TheGoldenPorkchop/RCETLaserArcade/VBArcadeControl/VBArcadeControl/Resources/UIPlayer4.png

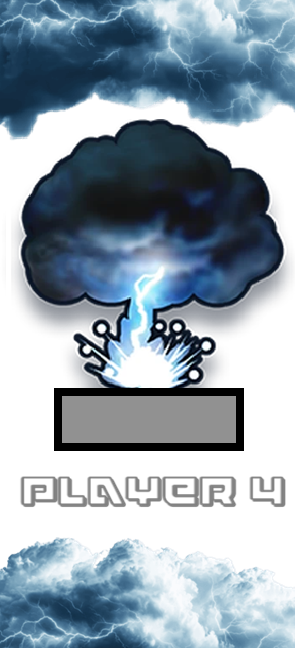
VBArcadeControl/VBArcadeControl/Resources/UIPlayer4.png
