TheGoldenPorkchop/RCETLaserArcade/KiCad/Target_Jumper/Target_Jumper_RevA/Target_Jumper.png

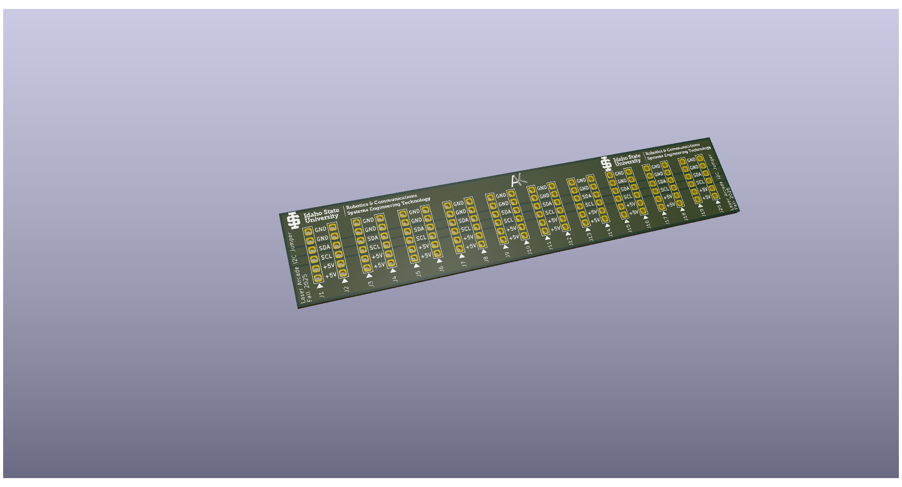
KiCad/Target_Jumper/Target_Jumper_RevA/Target_Jumper.png
