TheGoldenPorkchop/RCETLaserArcade/KiCad/Target_Jumper/Target_Jumper_RevA/LA_TargetJumper_RevA_BottomSchematic.pdf

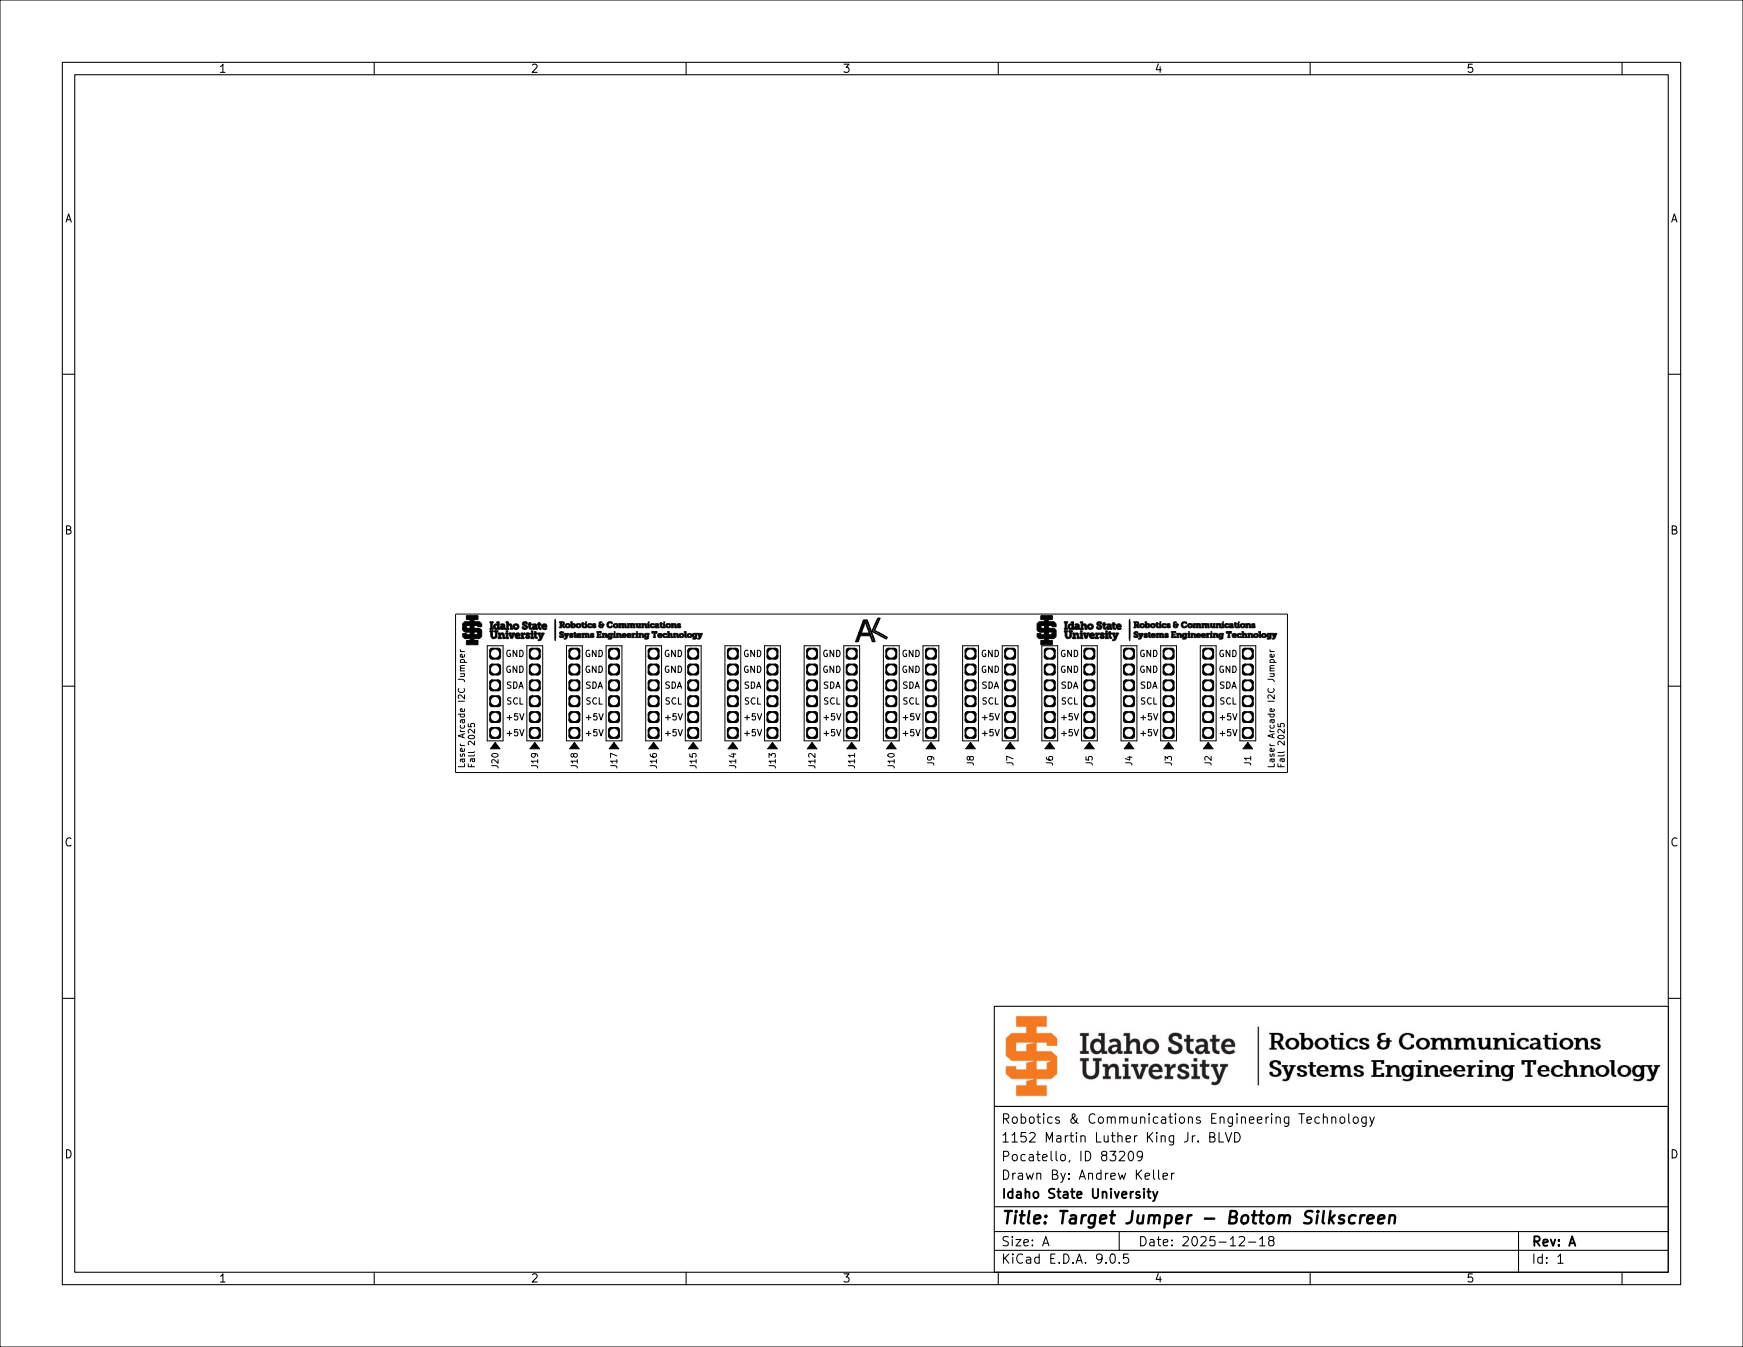
[picture p7: page 1]
