TheGoldenPorkchop/RCETLaserArcade/KiCad/Target_Jumper/Target_Jumper_RevA/LA_TargetJumper_RevA_Mechanical.pdf

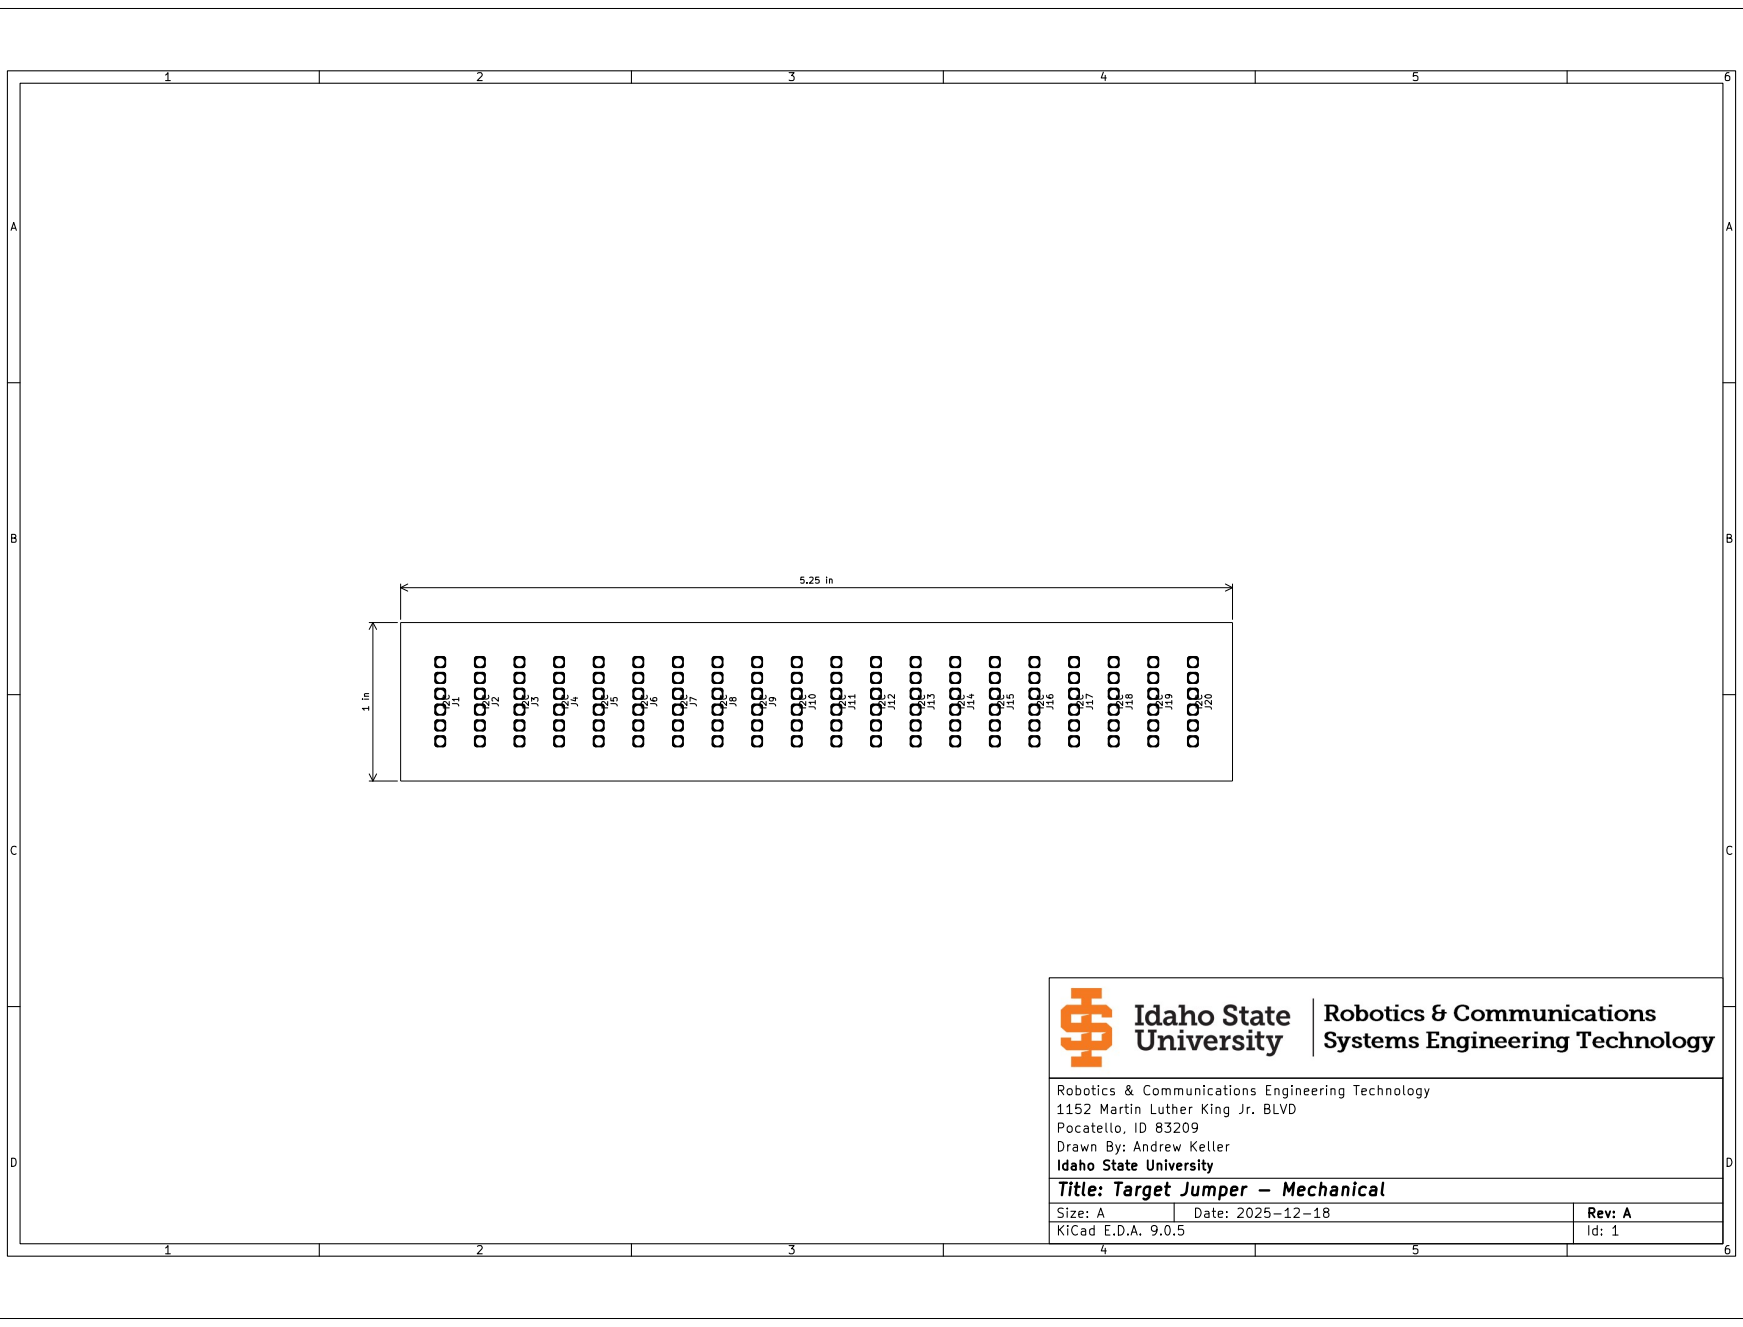
[picture p8: page 1]
