TheGoldenPorkchop/RCETLaserArcade/KiCad/Target_Jumper/Target_Jumper_RevA/LA_TargetJumper_RevA_Schematic.pdf

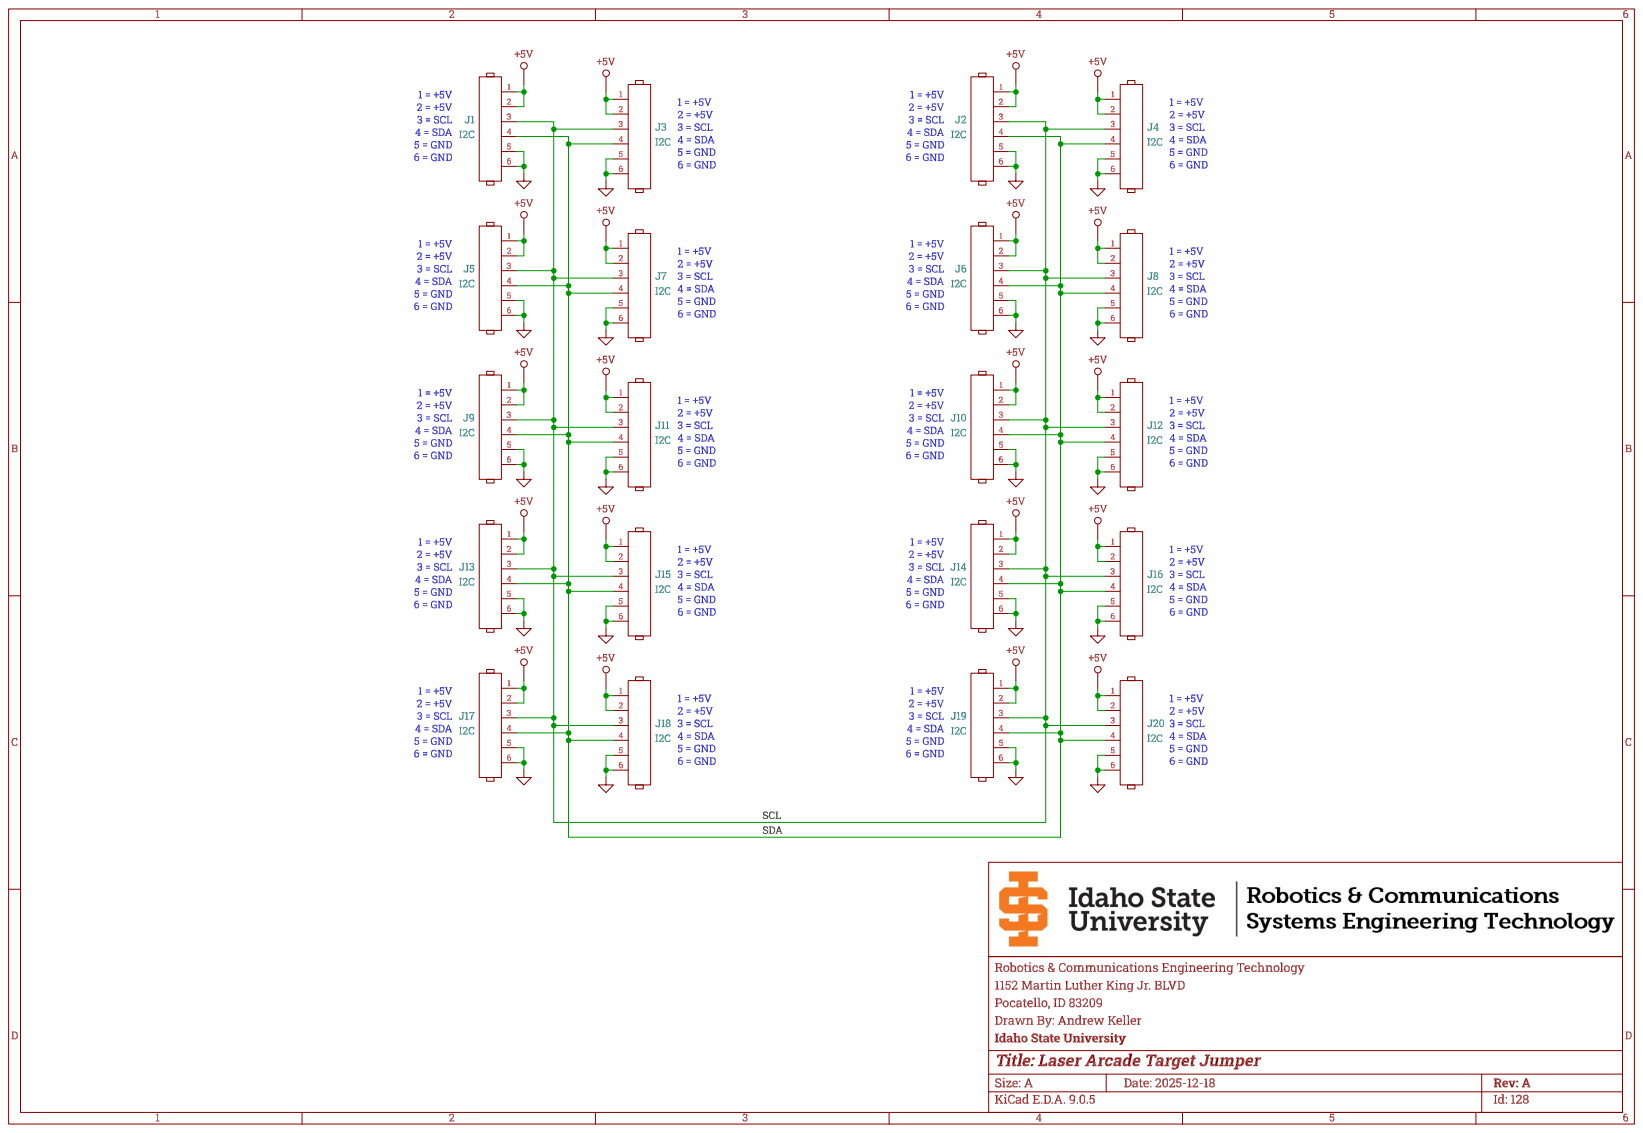
[picture p9: page 1]
