TheGoldenPorkchop/RCETLaserArcade/KiCad/Target_Master/Target_Master_RevB/LA_TargetMaster_RevB_Schematic.pdf

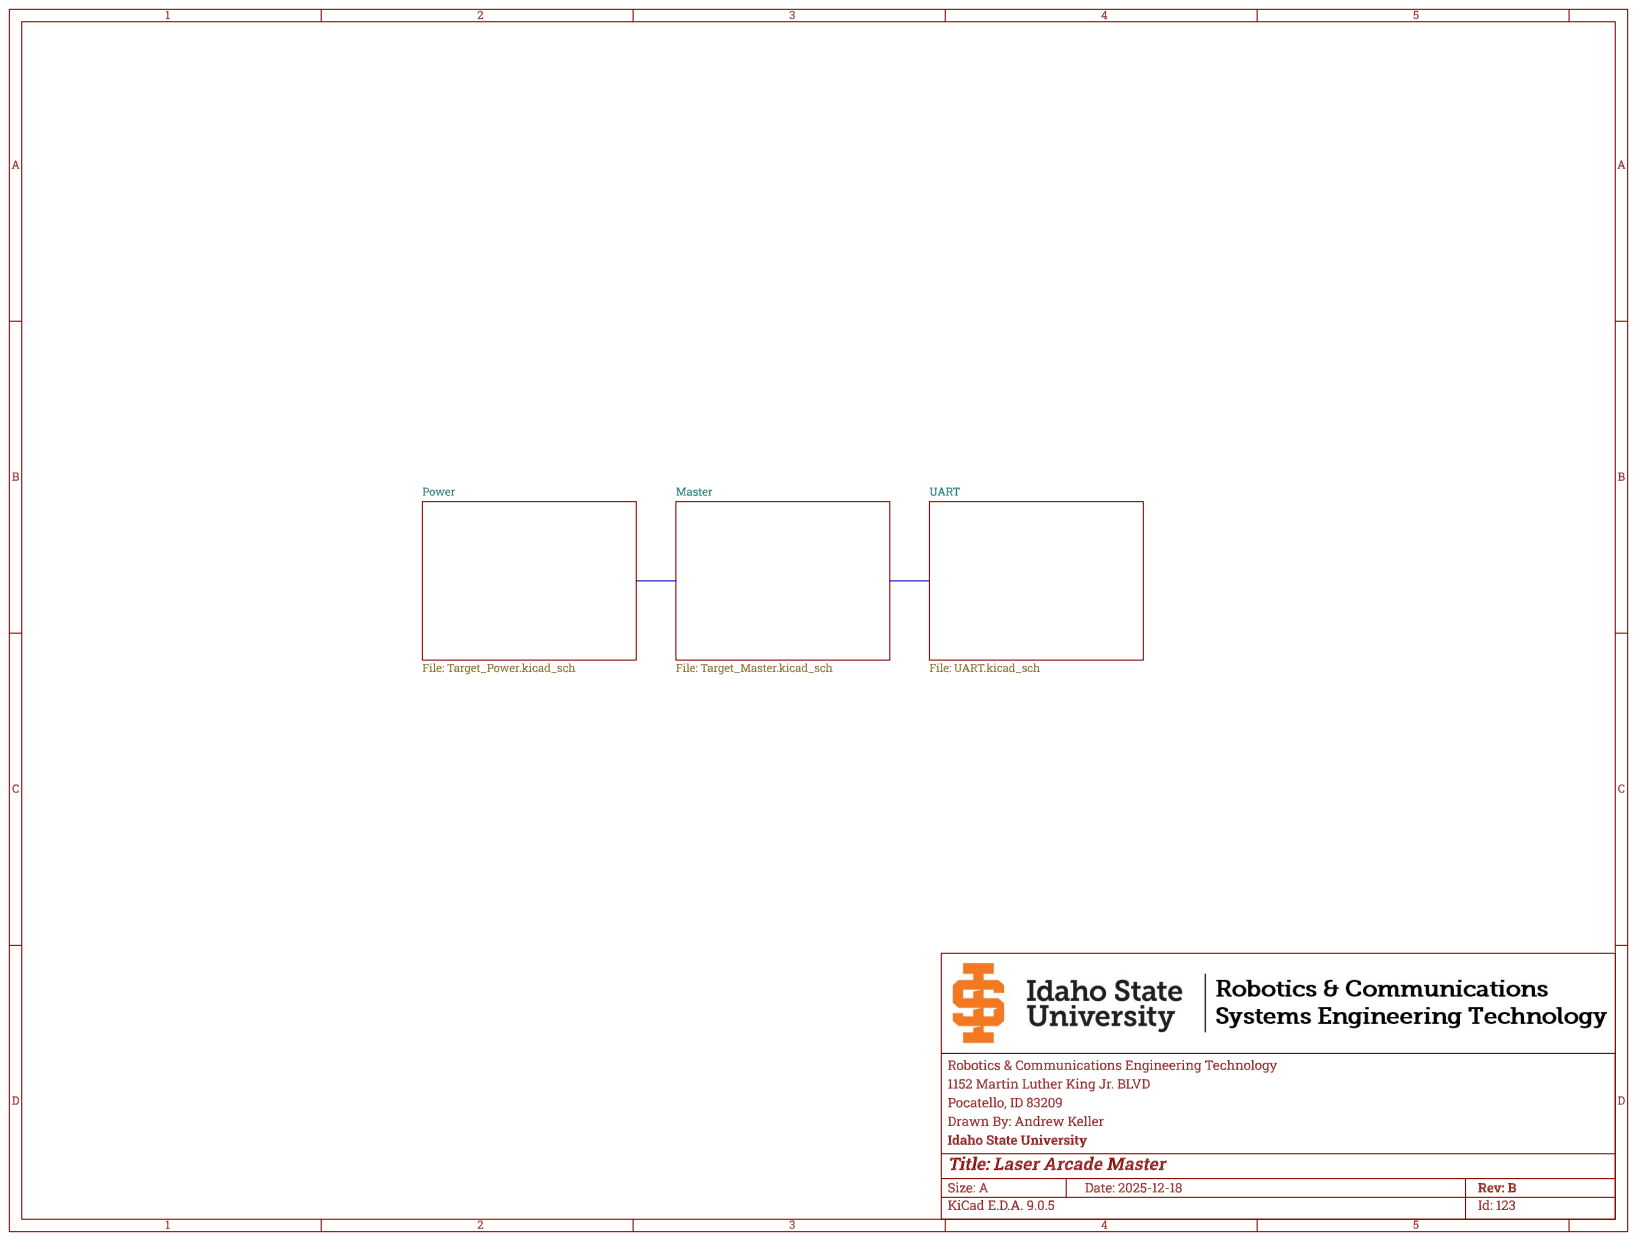
[picture p10: page 1]

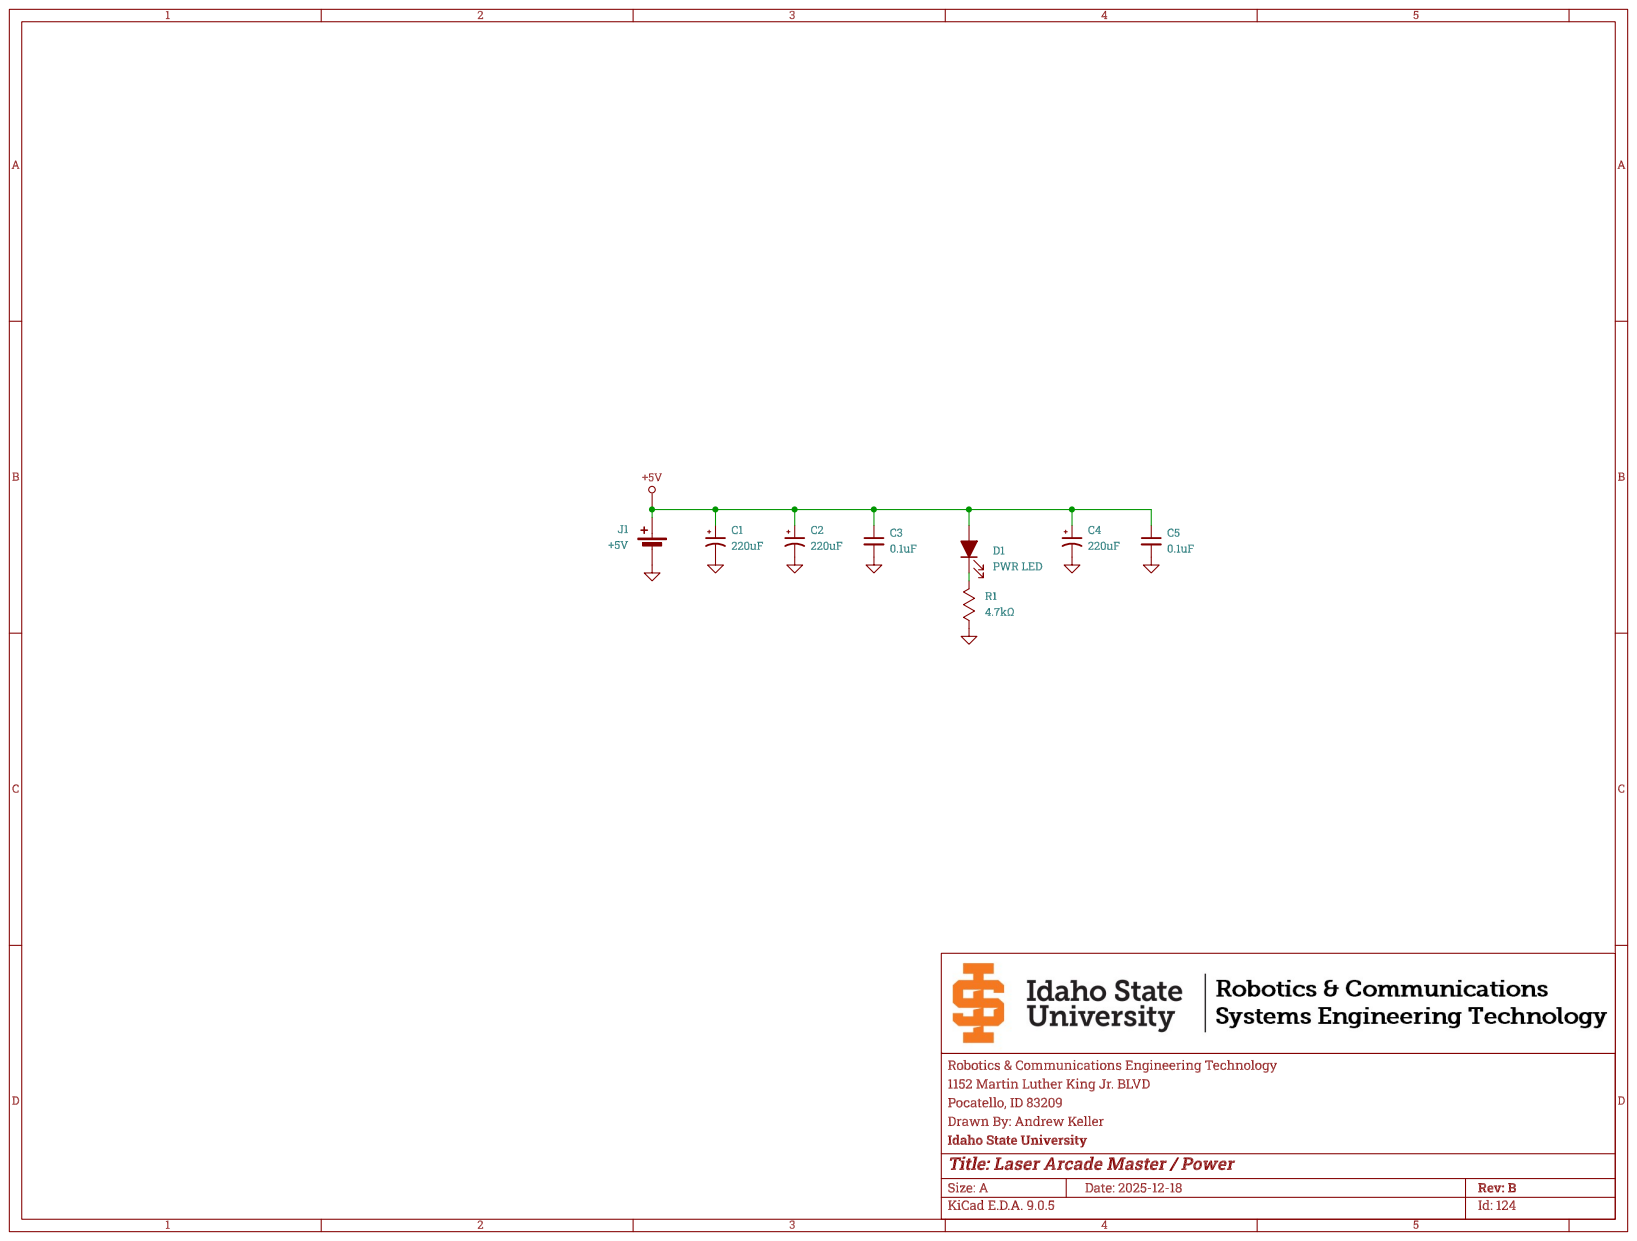
[picture p11: page 2]

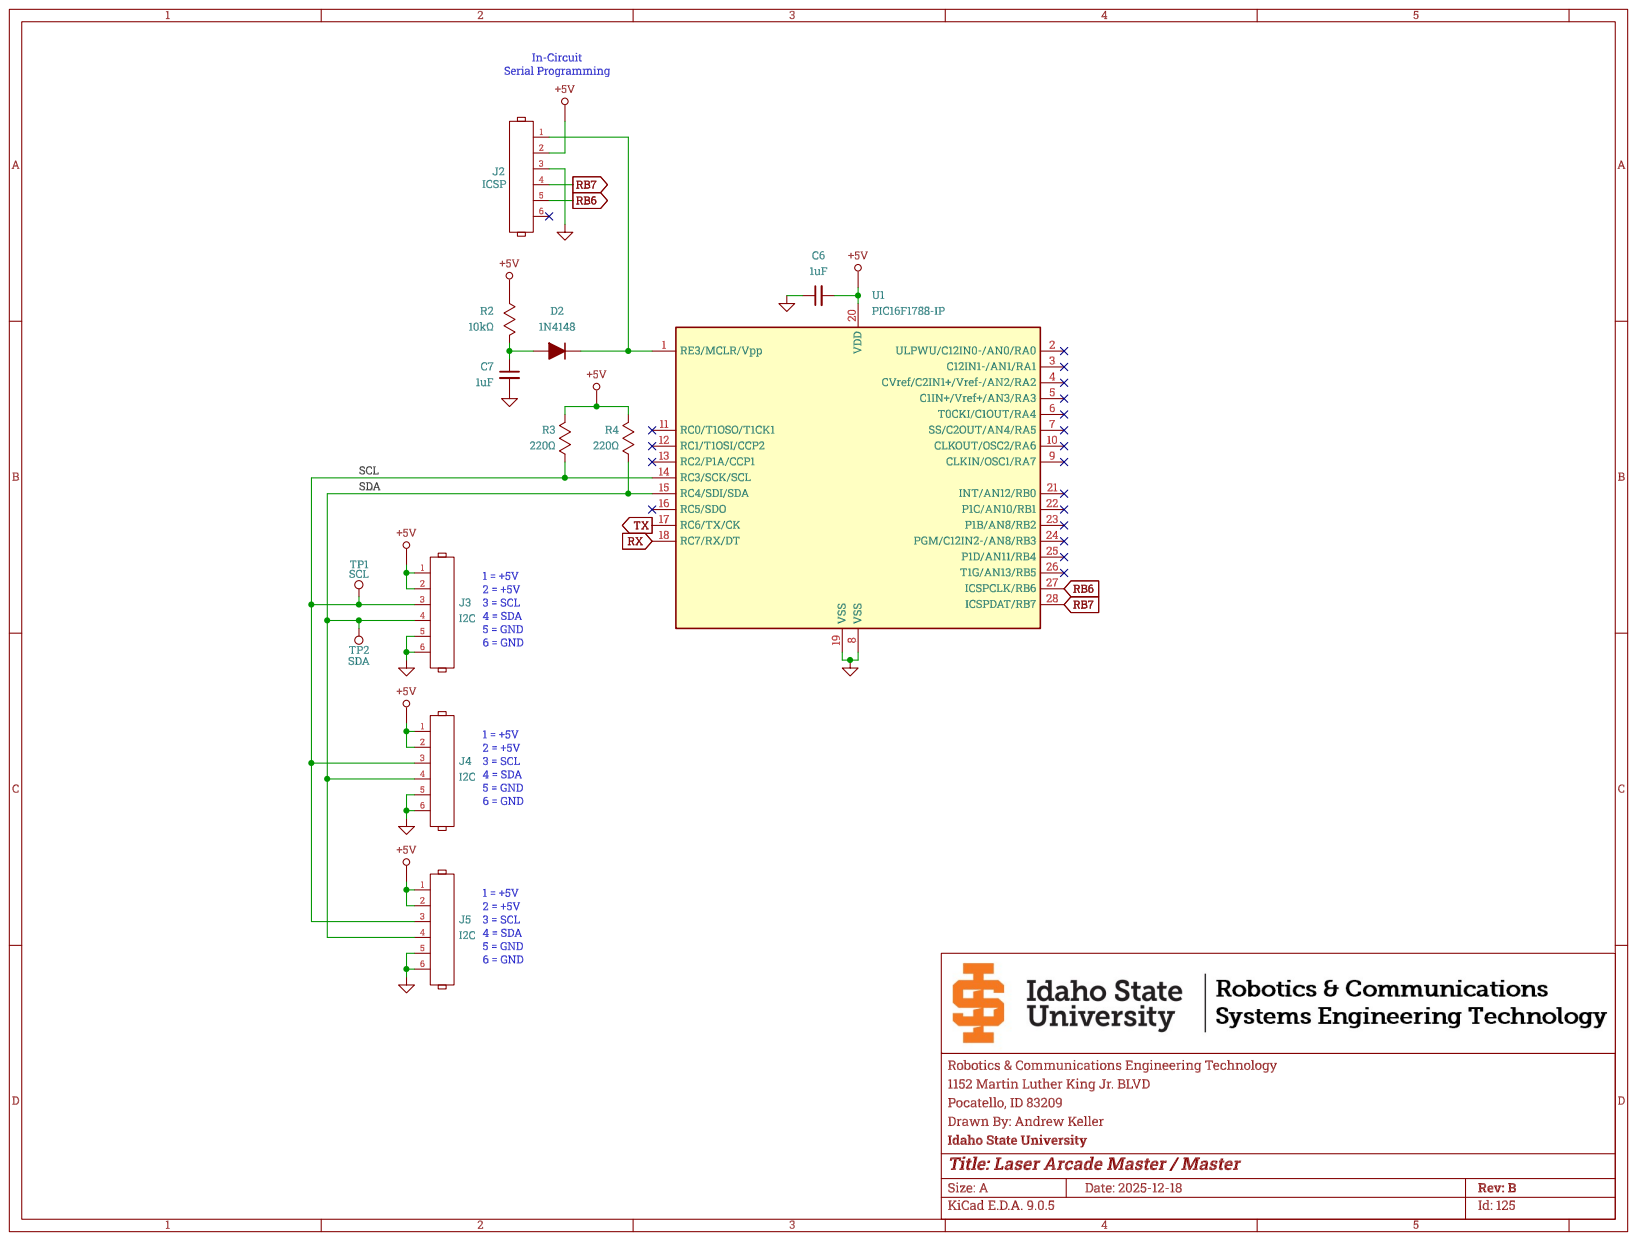
[picture p12: page 3]

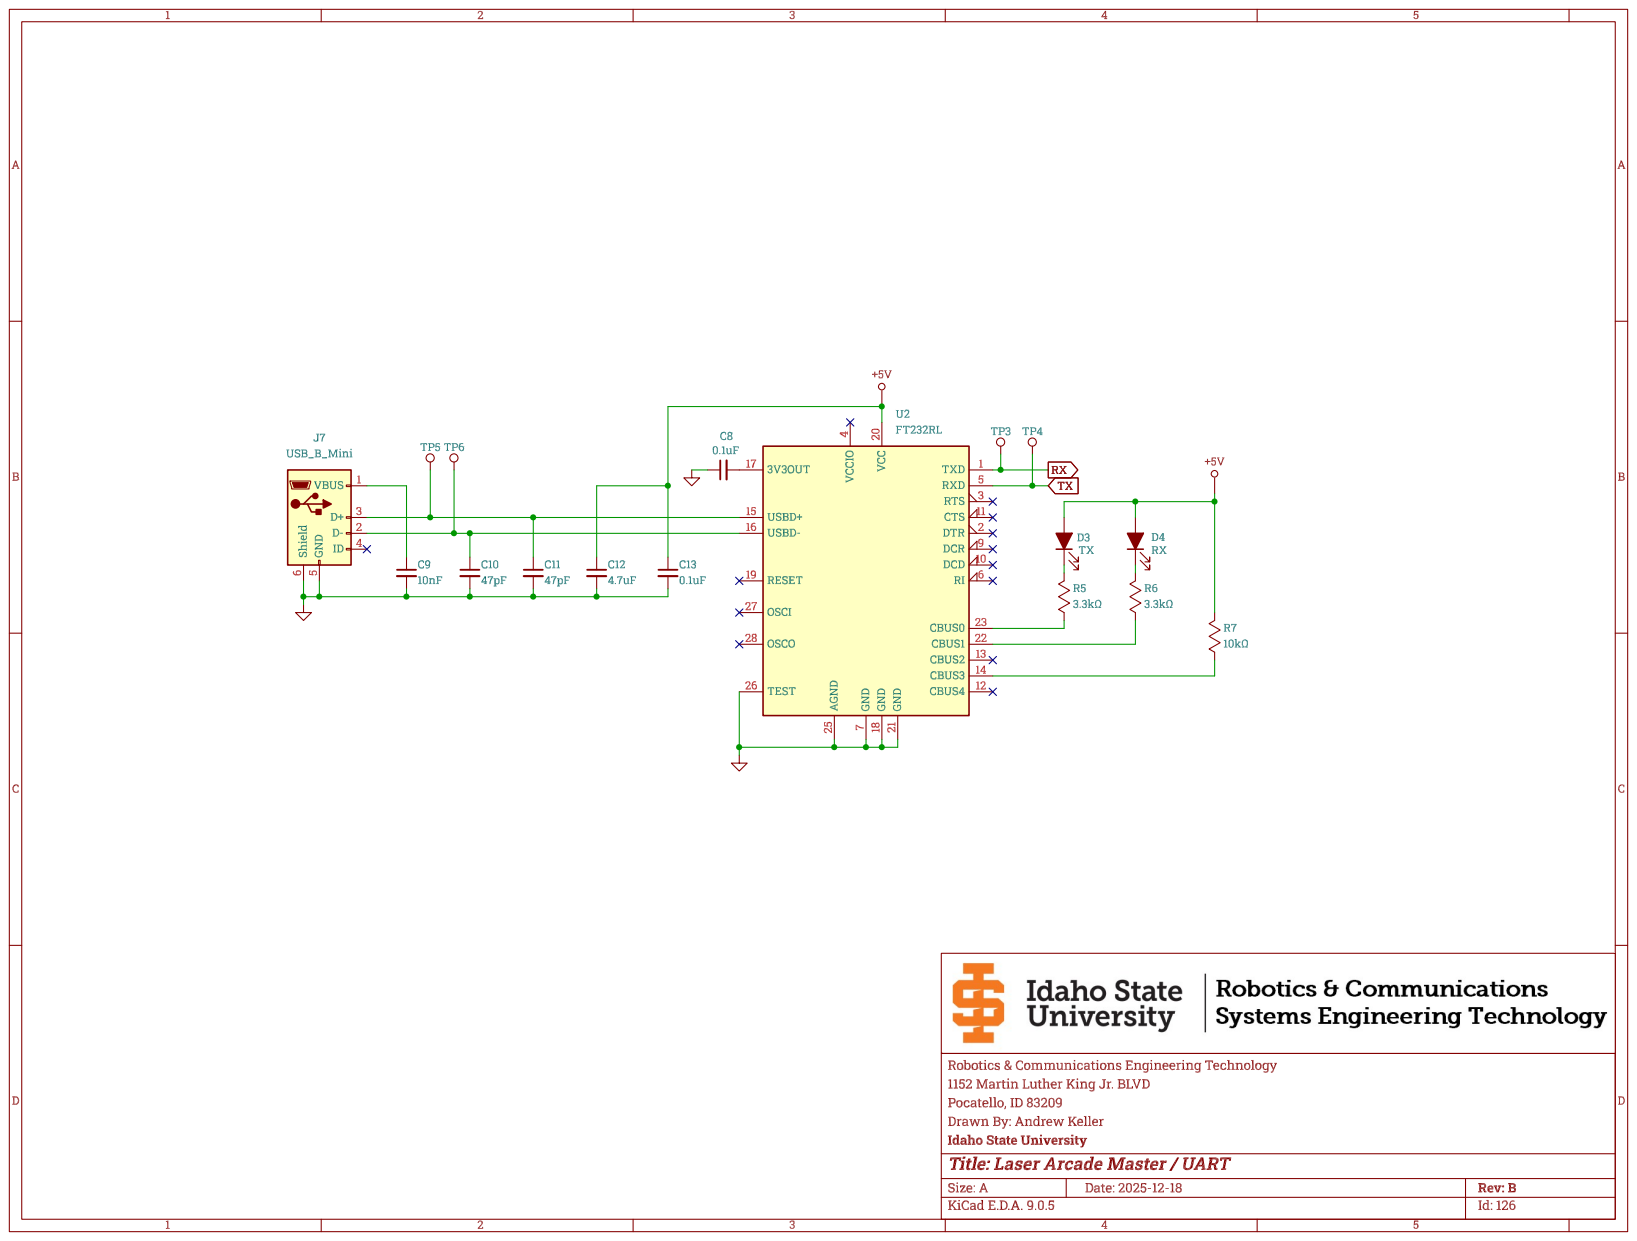
[picture p13: page 4]
