TheGoldenPorkchop/RCETLaserArcade/KiCad/Target_Slave/Target_Slave_RevB/LA_TargetSlave_RevB_Schematic.pdf

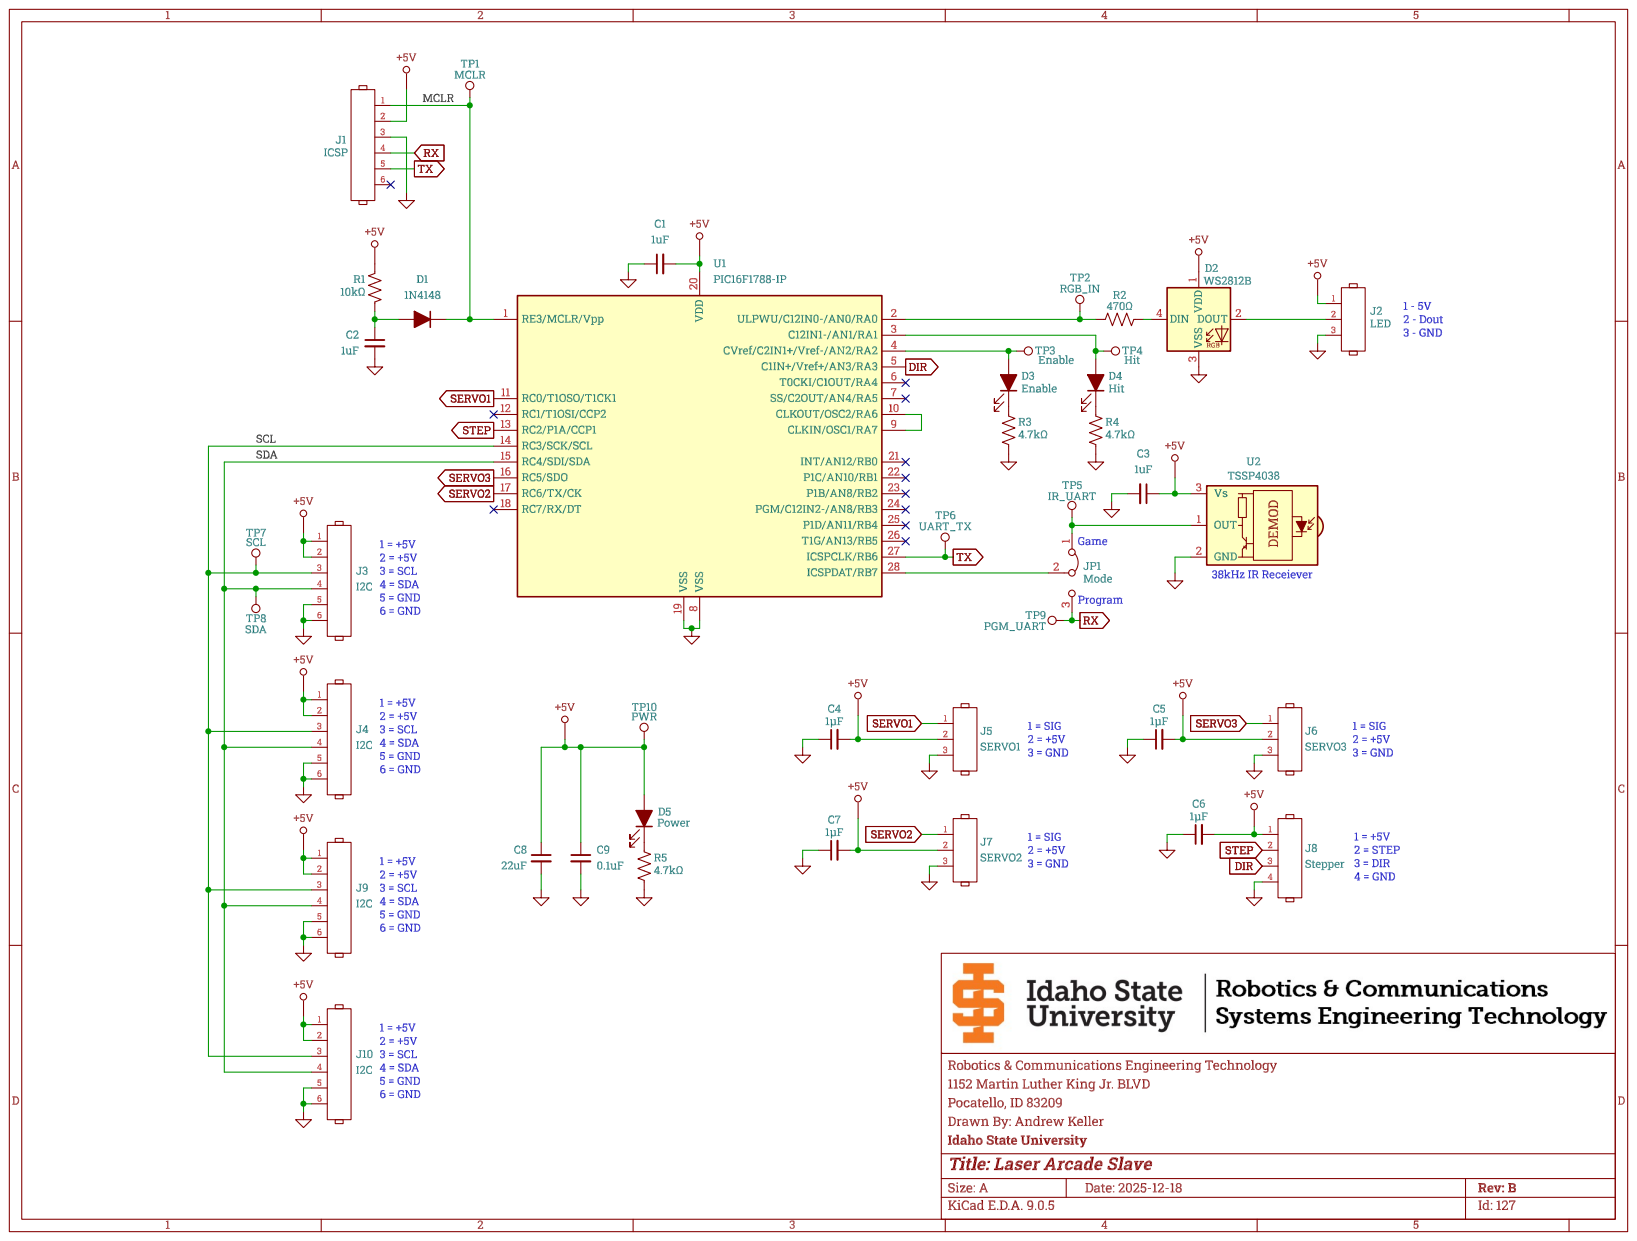
[picture p14: page 1]
