TheGoldenPorkchop/RCETLaserArcade/KiCad/Blaster/LA_Blaster_RevB/LA_Blaster_RevB_Mechanical.pdf

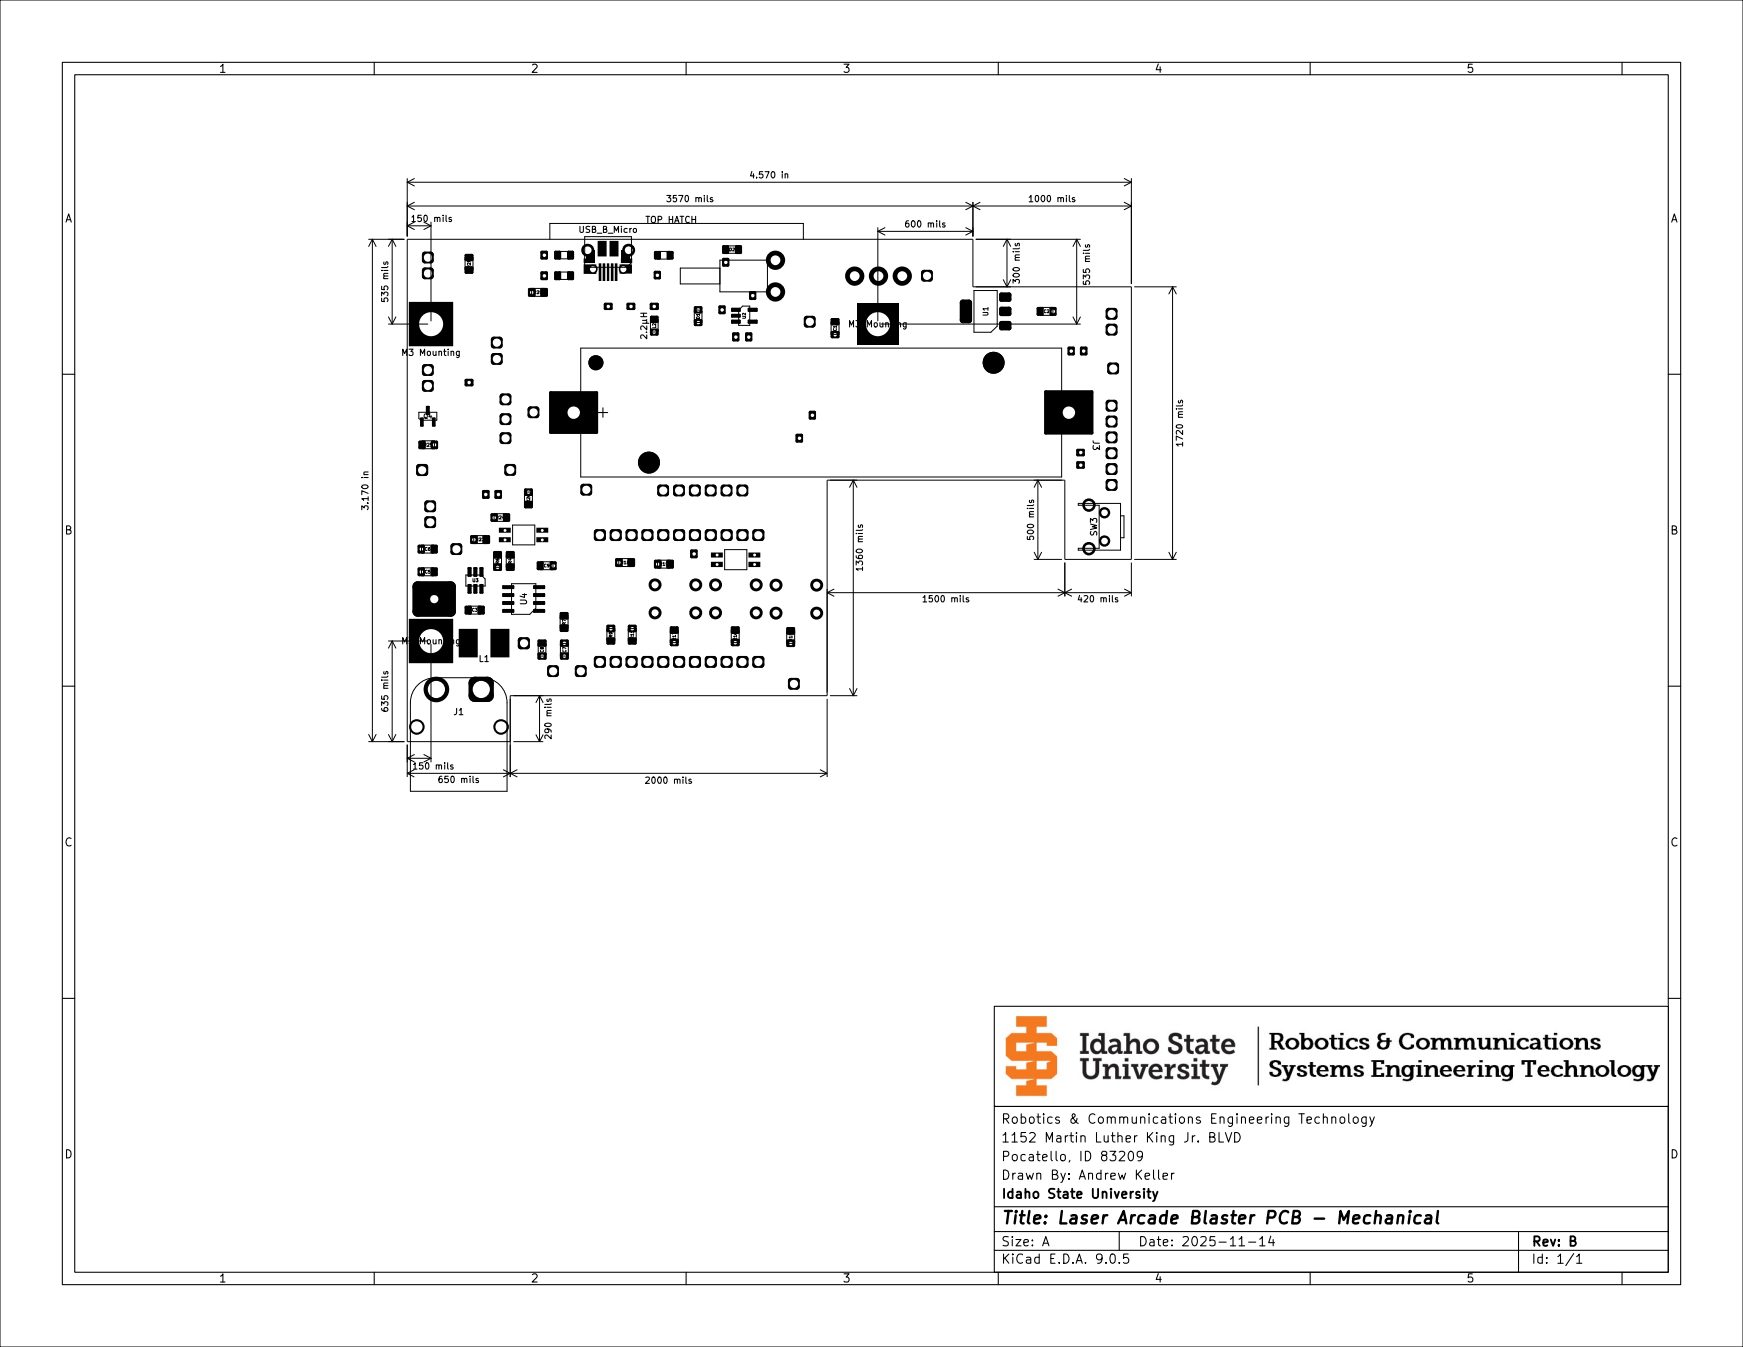
[picture p15: page 1]
