TheGoldenPorkchop/RCETLaserArcade/KiCad/Target_Jumper/Target_Jumper_RevA/LA_TargetJumper_RevA_BottomCopper.pdf

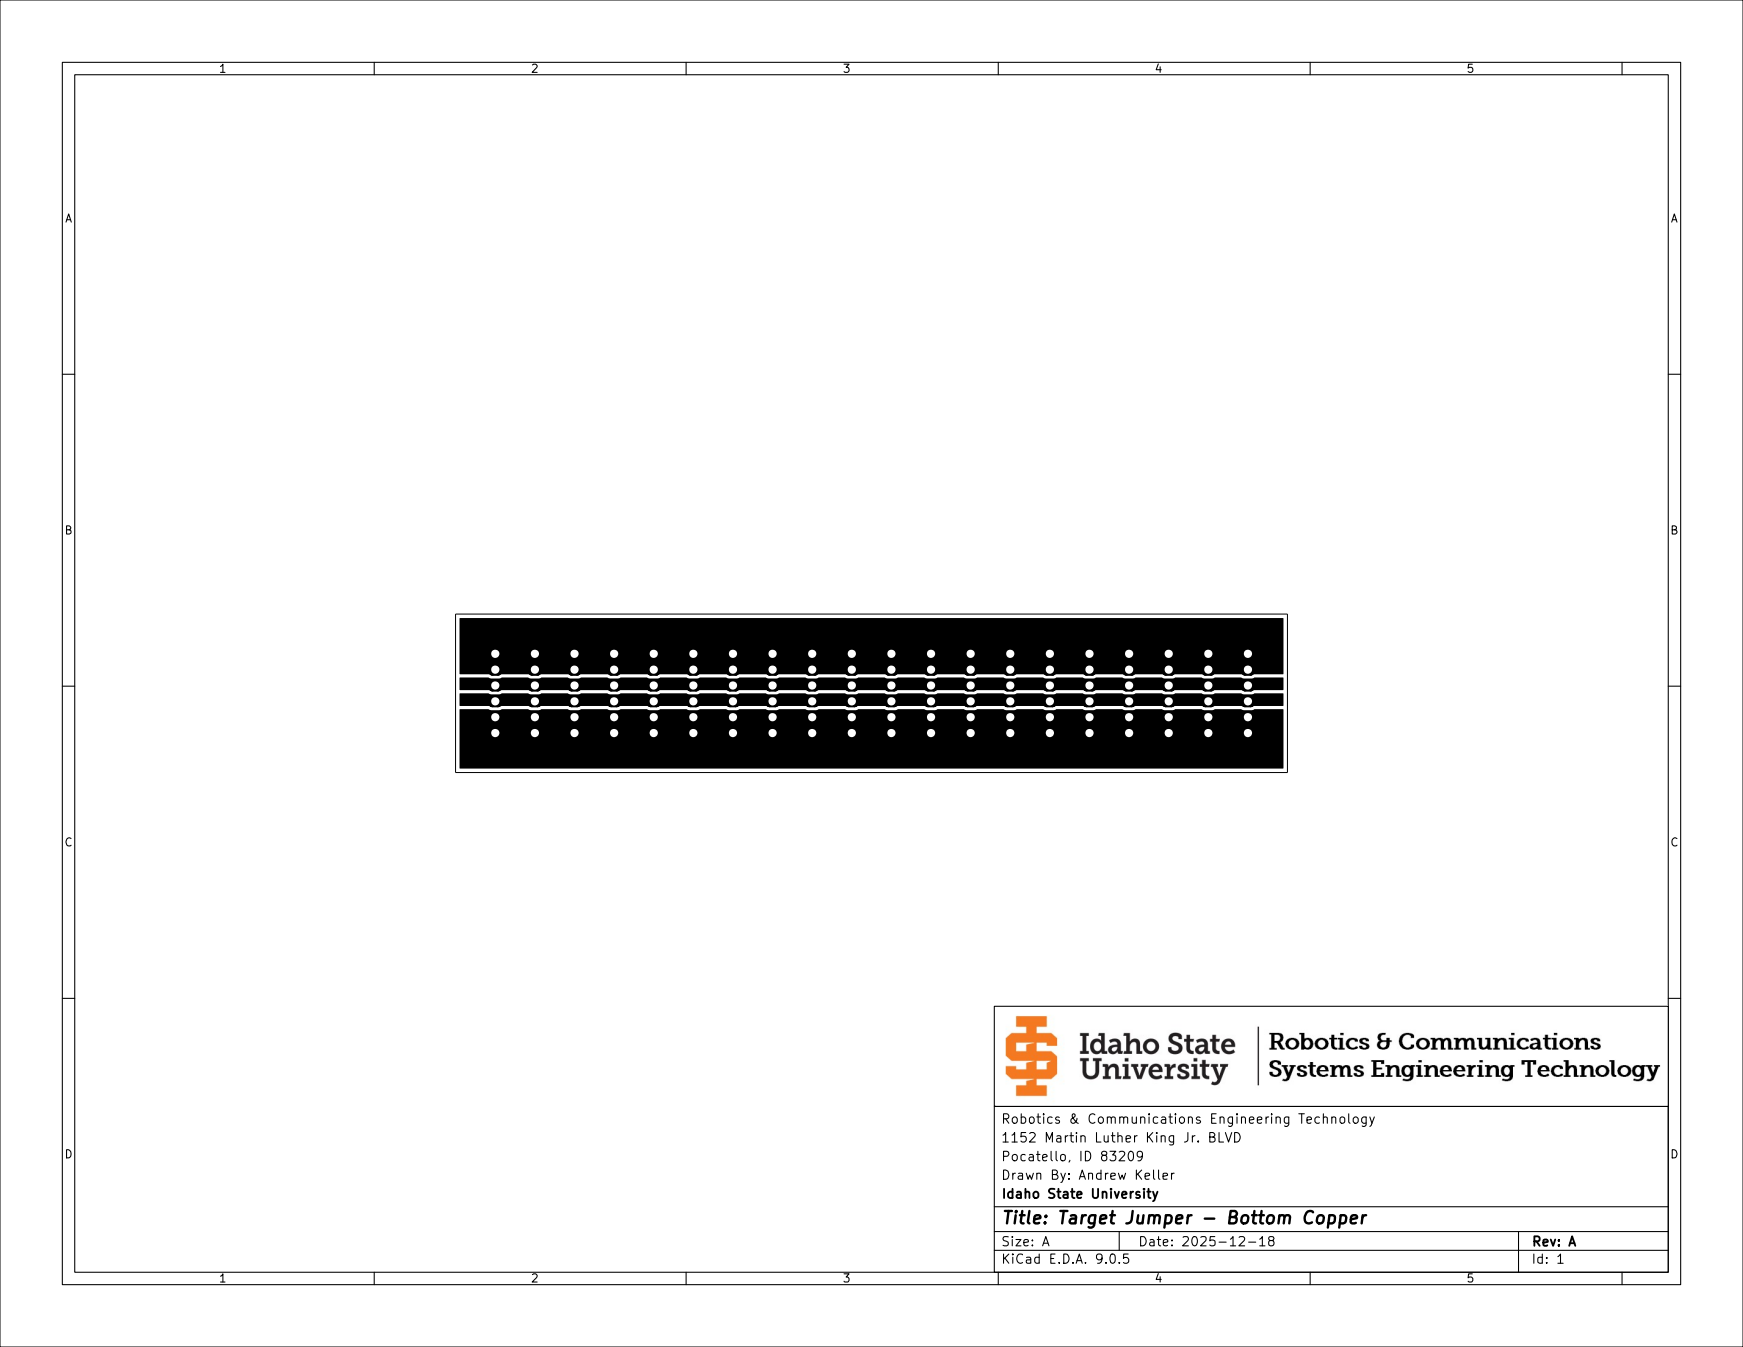
[picture p16: page 1]
