TheGoldenPorkchop/RCETLaserArcade/KiCad/Target_Jumper/Target_Jumper_RevA/LA_TargetJumper_RevA_TopCopper.pdf

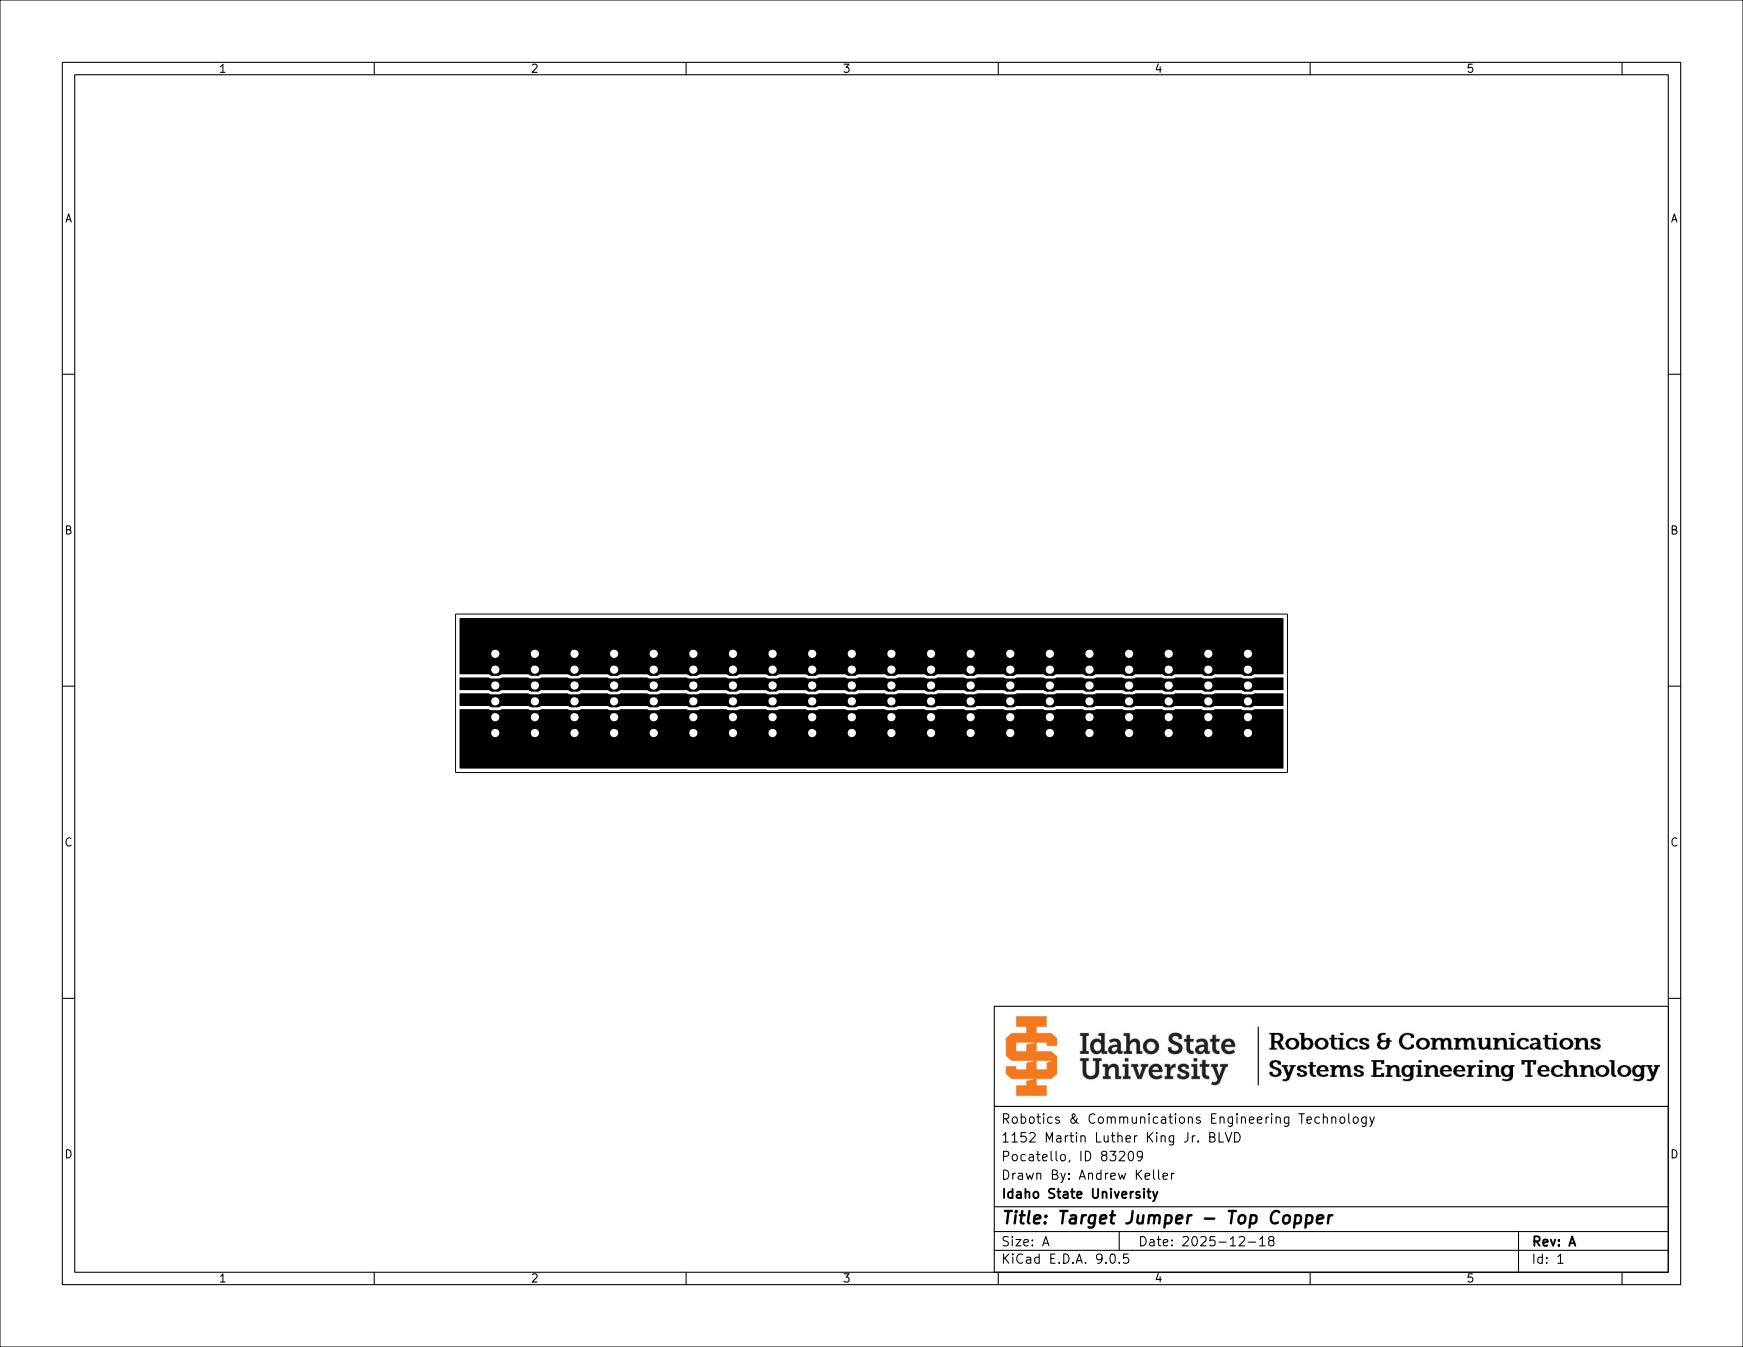
[picture p17: page 1]
