TheGoldenPorkchop/RCETLaserArcade/KiCad/Blaster/LA_Blaster_RevB/LA_Blaster_RevB_BottomCopper.pdf

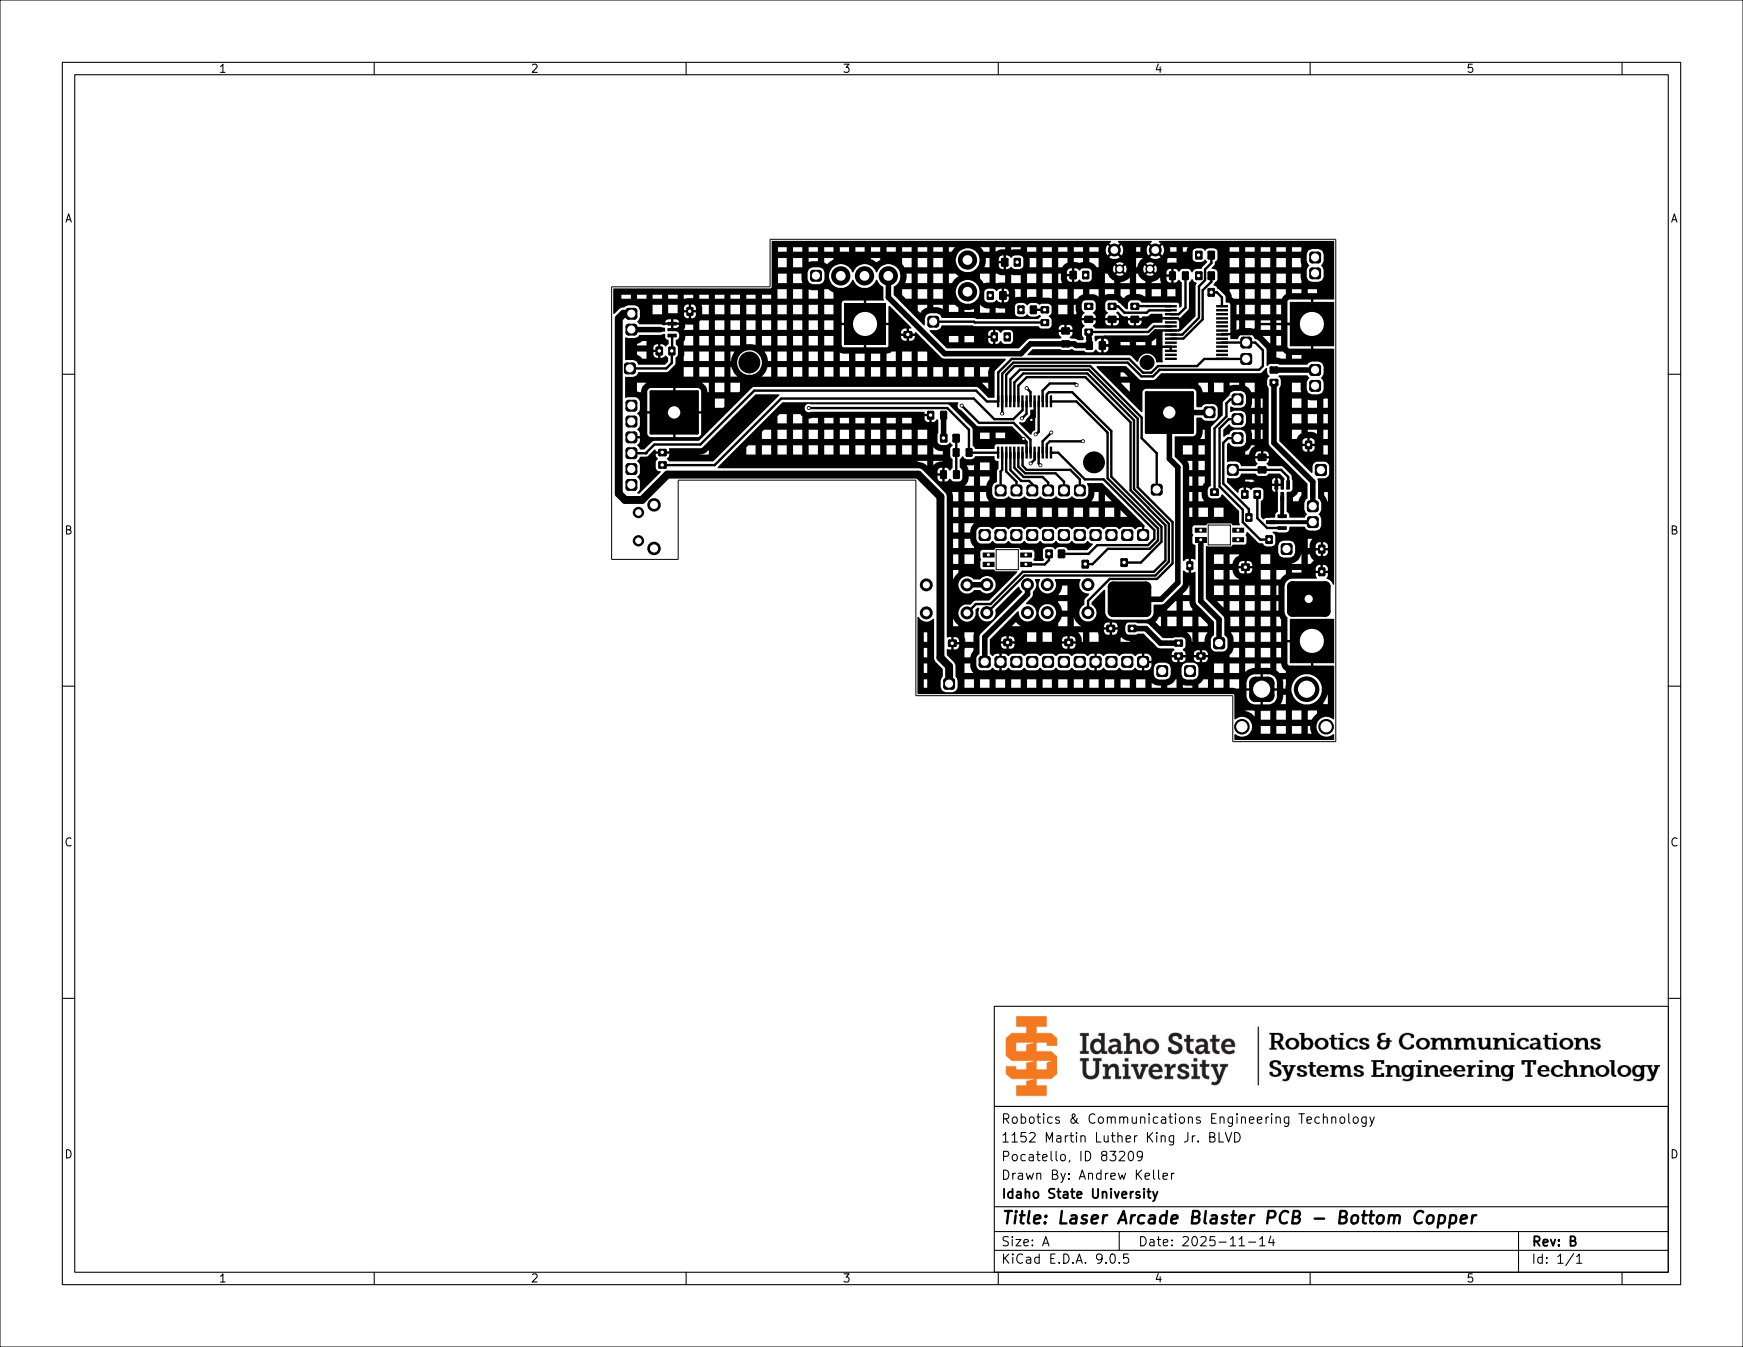
[picture p19: page 1]
