TheGoldenPorkchop/RCETLaserArcade/KiCad/Blaster/LA_Blaster_RevB/LA_Blaster_RevB_BottomSilkscreen.pdf

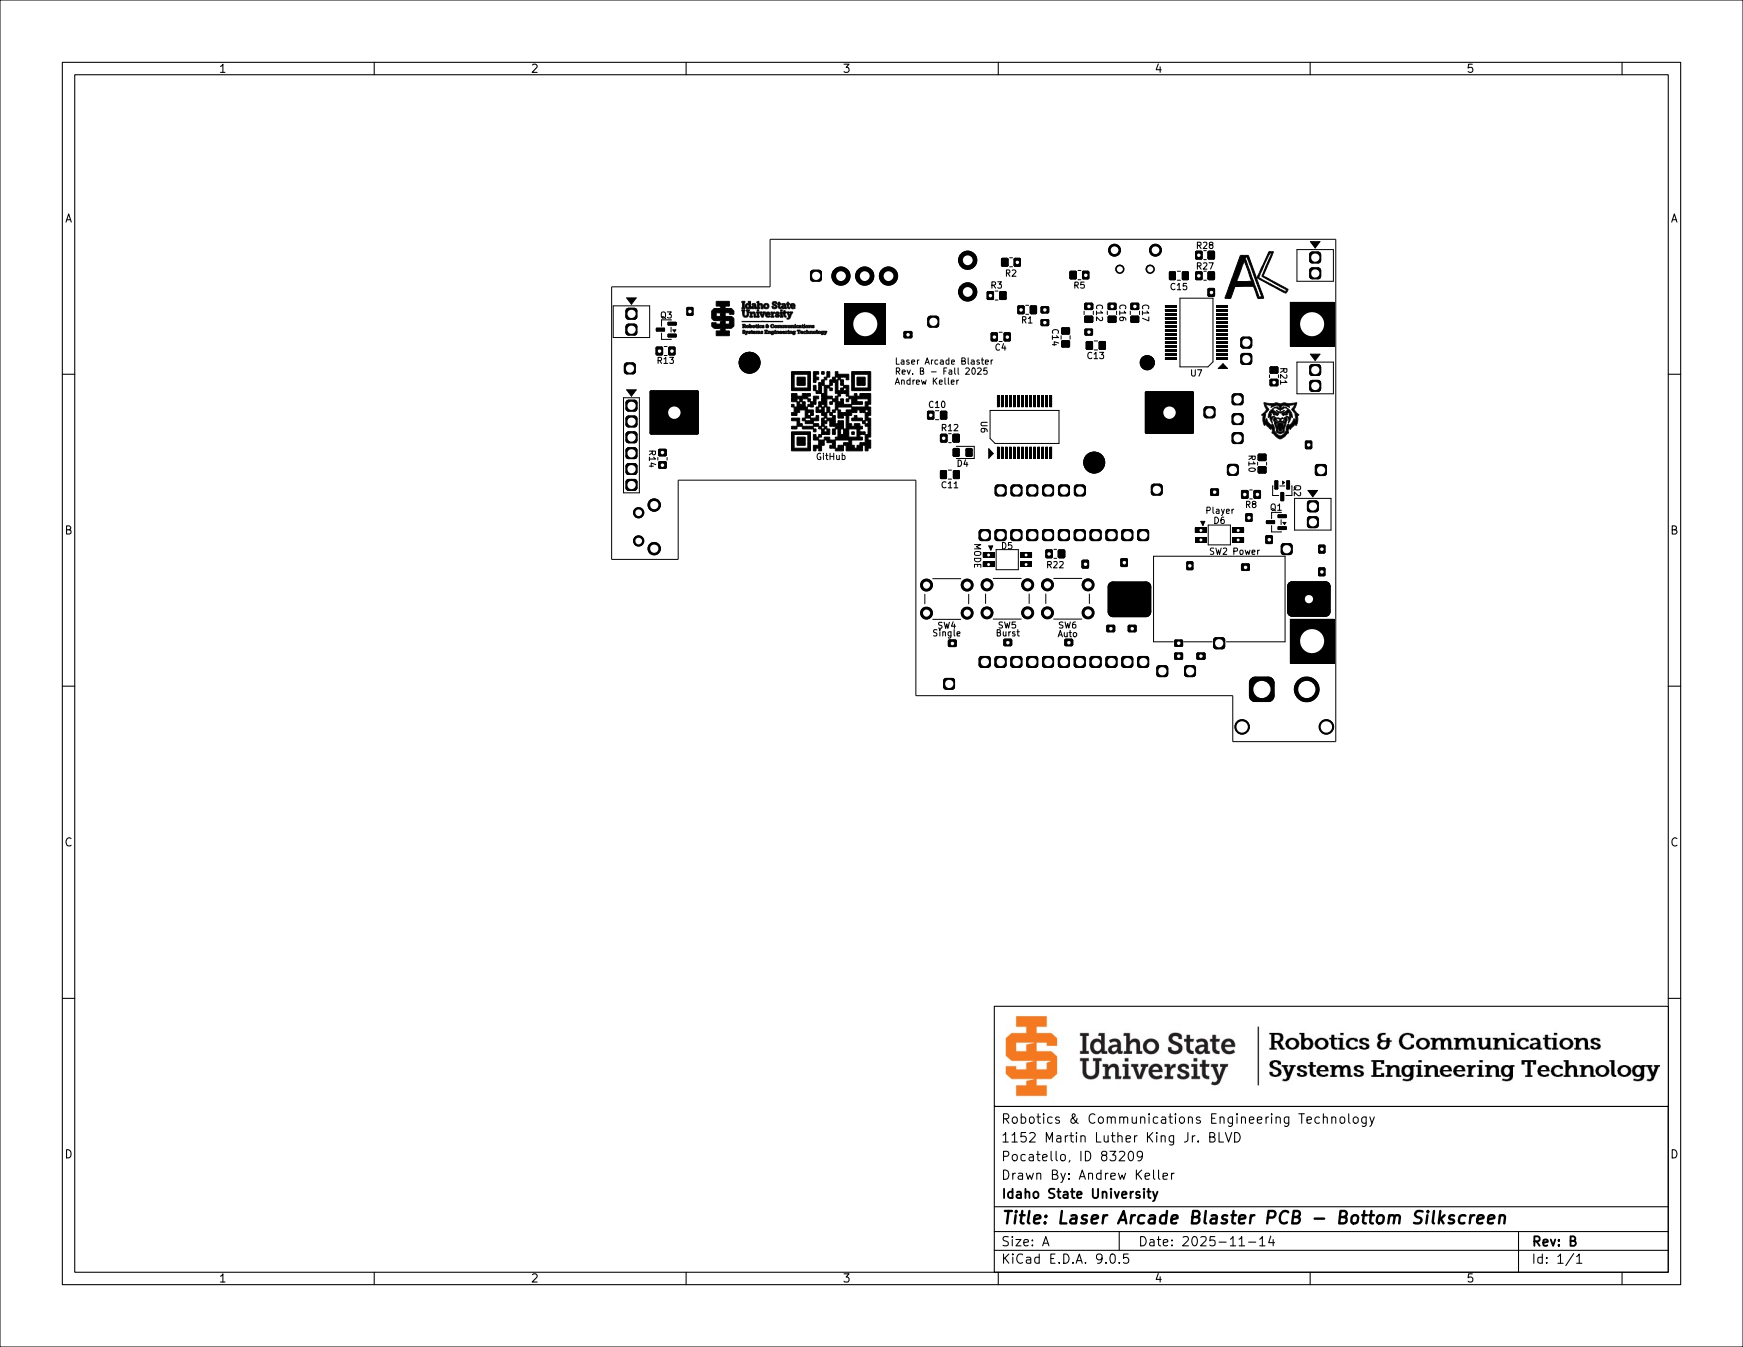
[picture p20: page 1]
