TheGoldenPorkchop/RCETLaserArcade/KiCad/Blaster/LA_Blaster_RevB/LA_Blaster_RevB_TopCopper.pdf

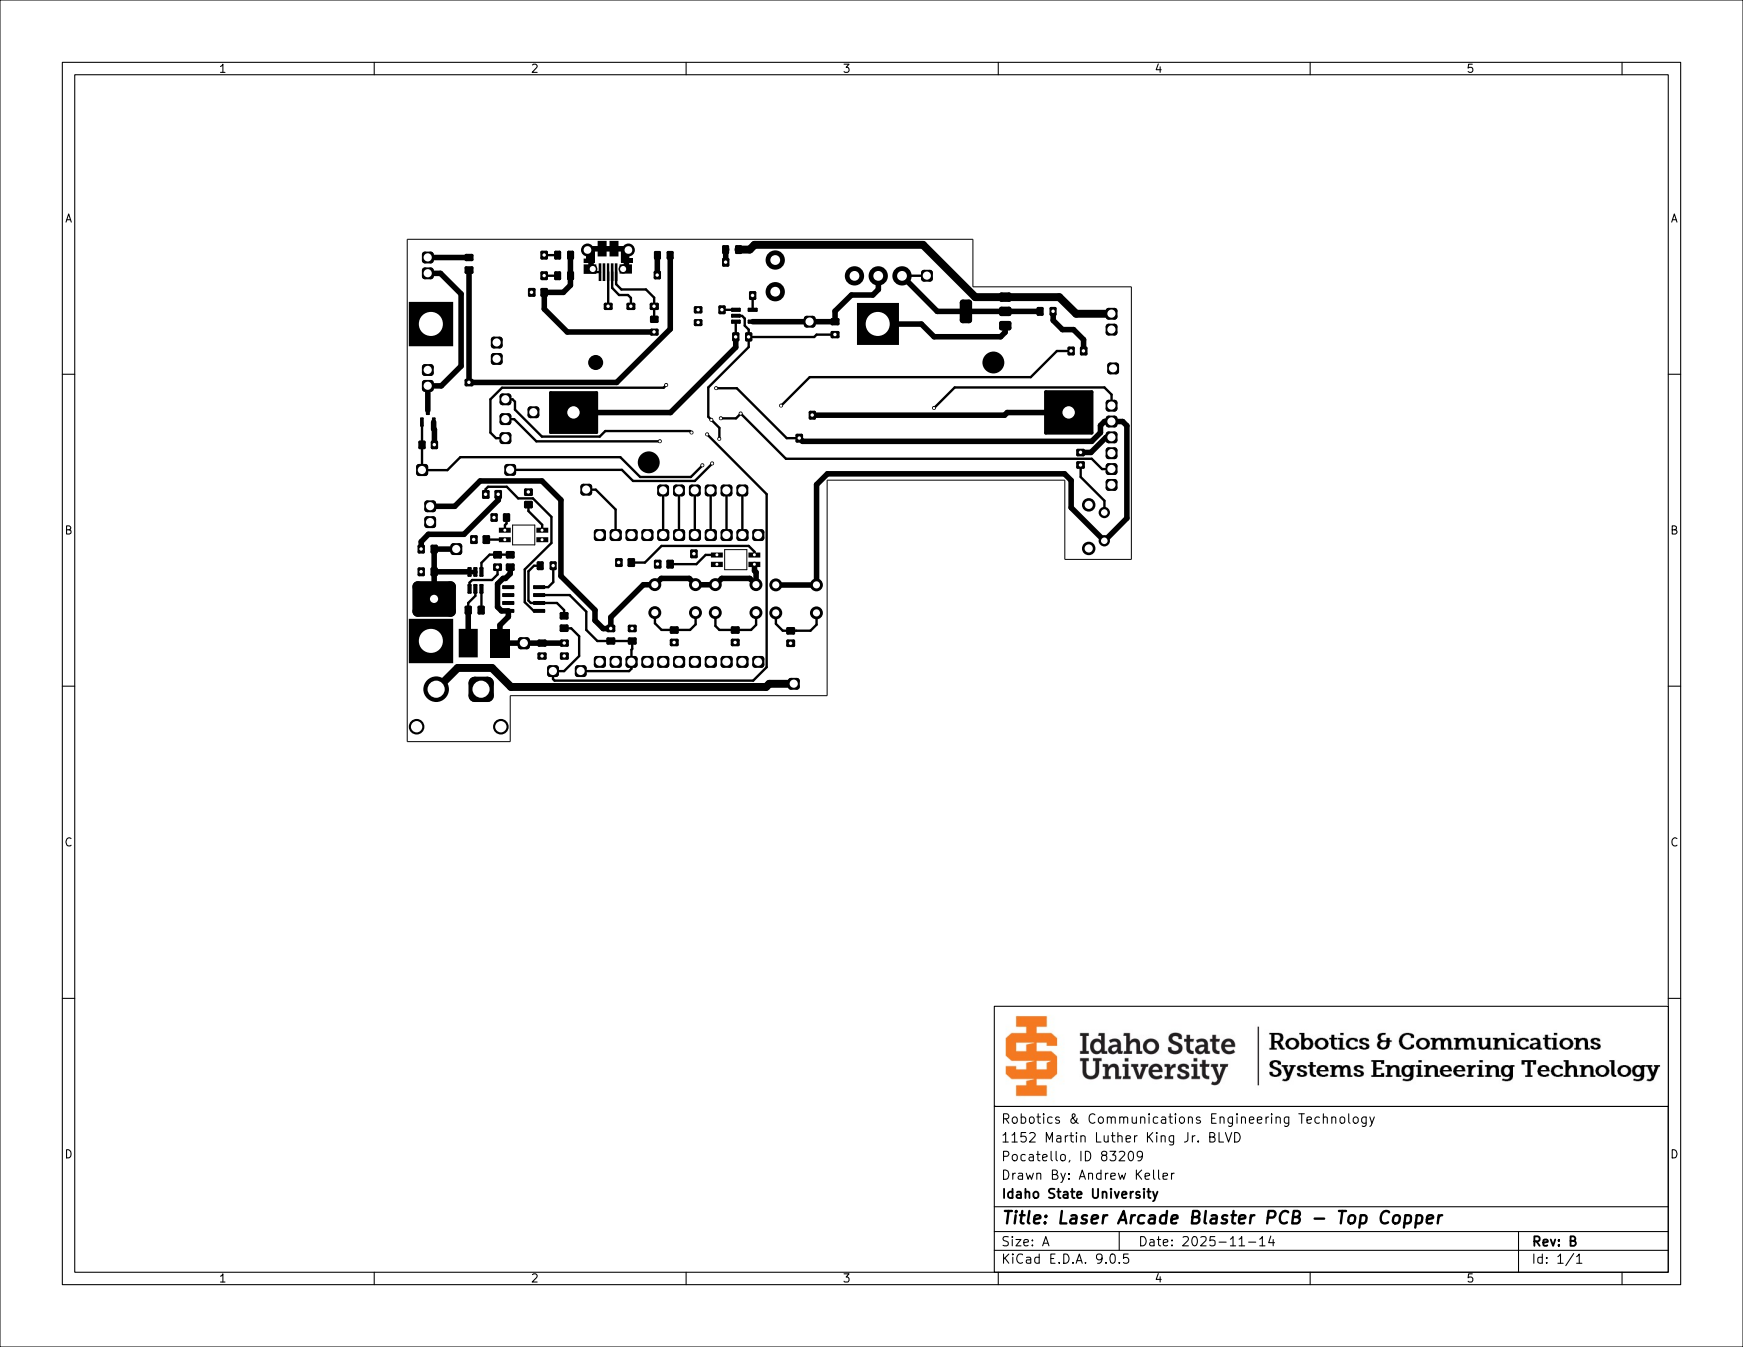
[picture p21: page 1]
