TheGoldenPorkchop/RCETLaserArcade/KiCad/Blaster/LA_Blaster_RevB/LA_Blaster_RevB_TopSilkscreen.pdf

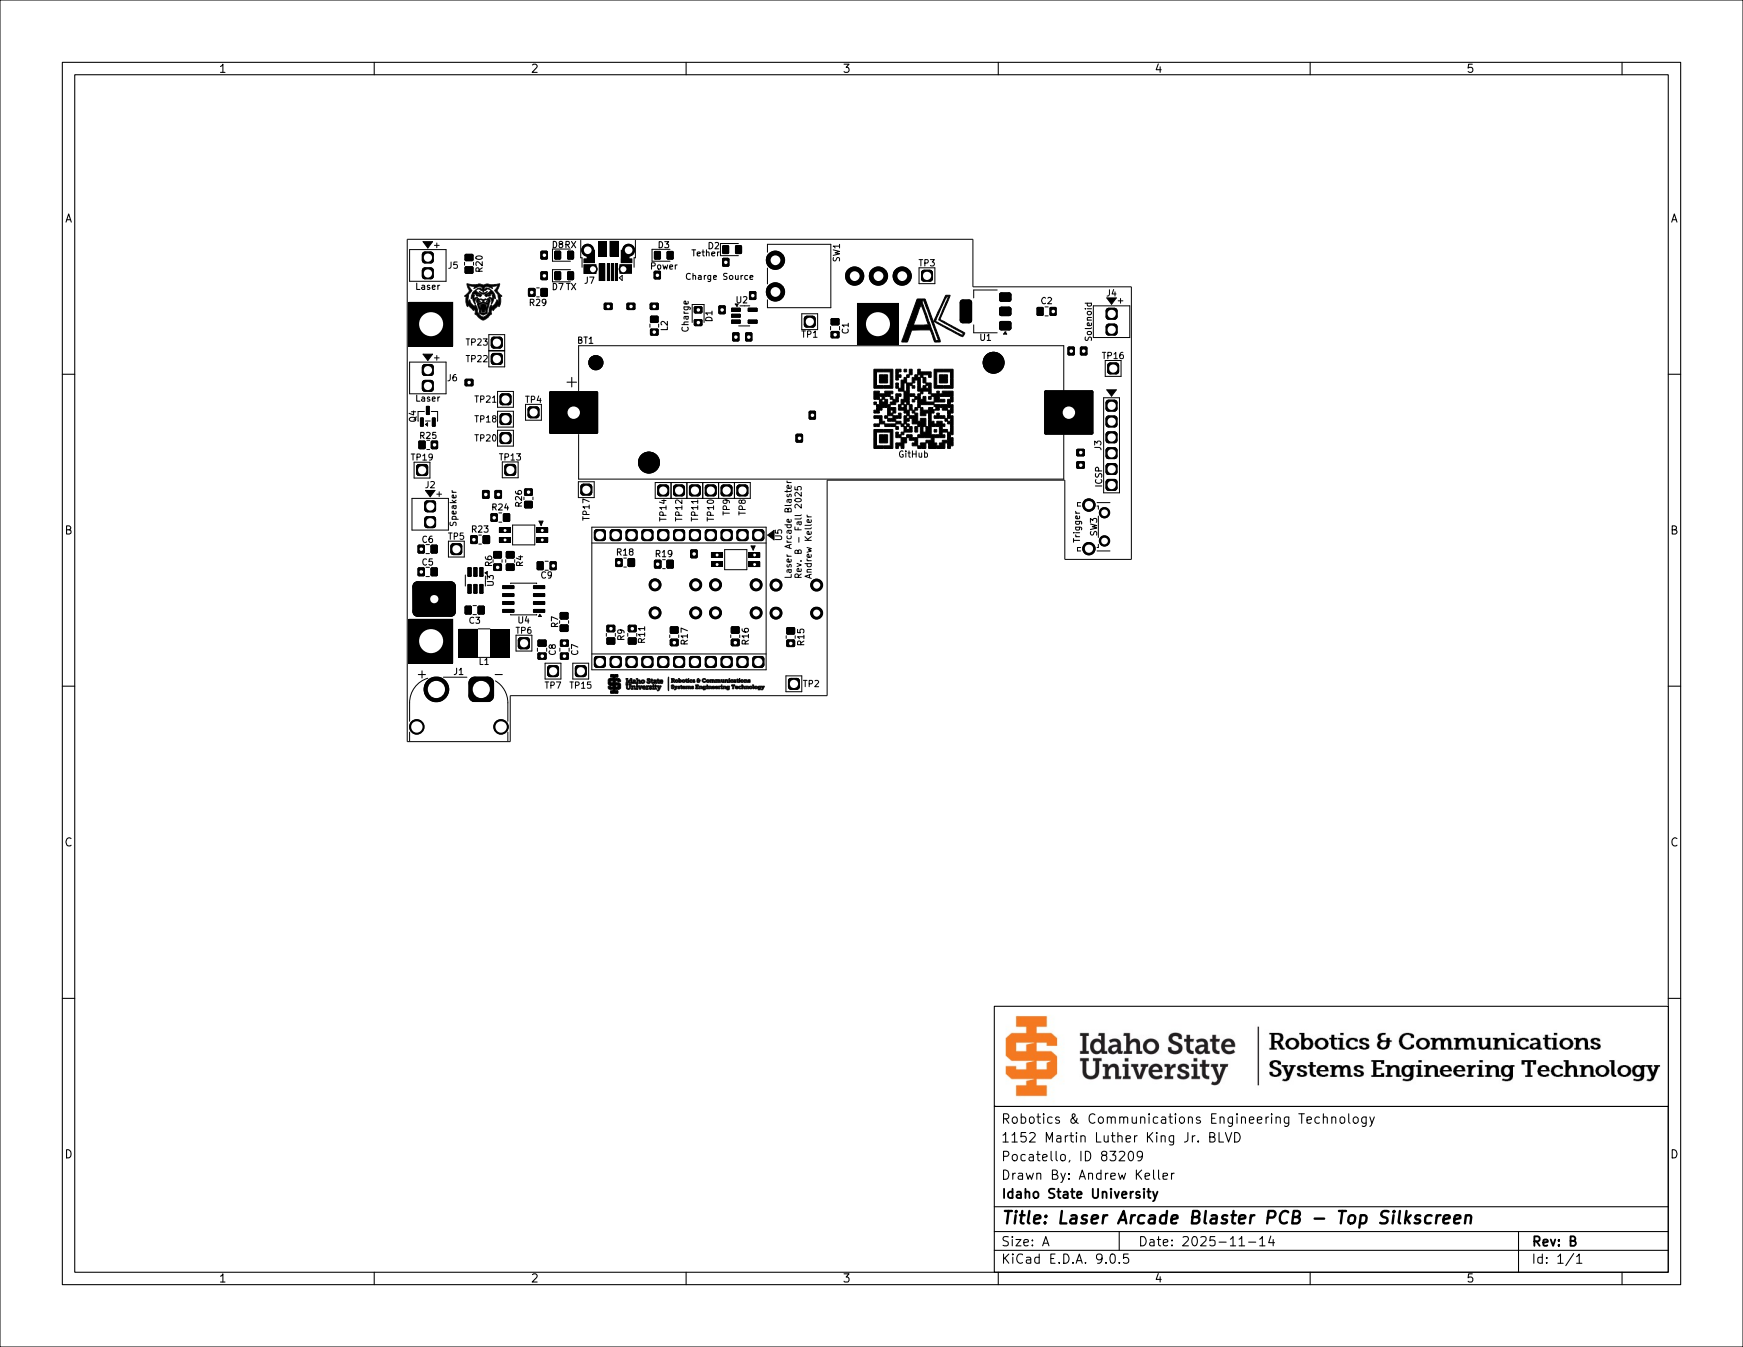
[picture p22: page 1]
