TheGoldenPorkchop/RCETLaserArcade/KiCad/Target_Slave/Target_Slave.kicad_pcb

## KiCad design KiCad/Target_Slave/Target_Slave.kicad_pcb (2025-11-17)

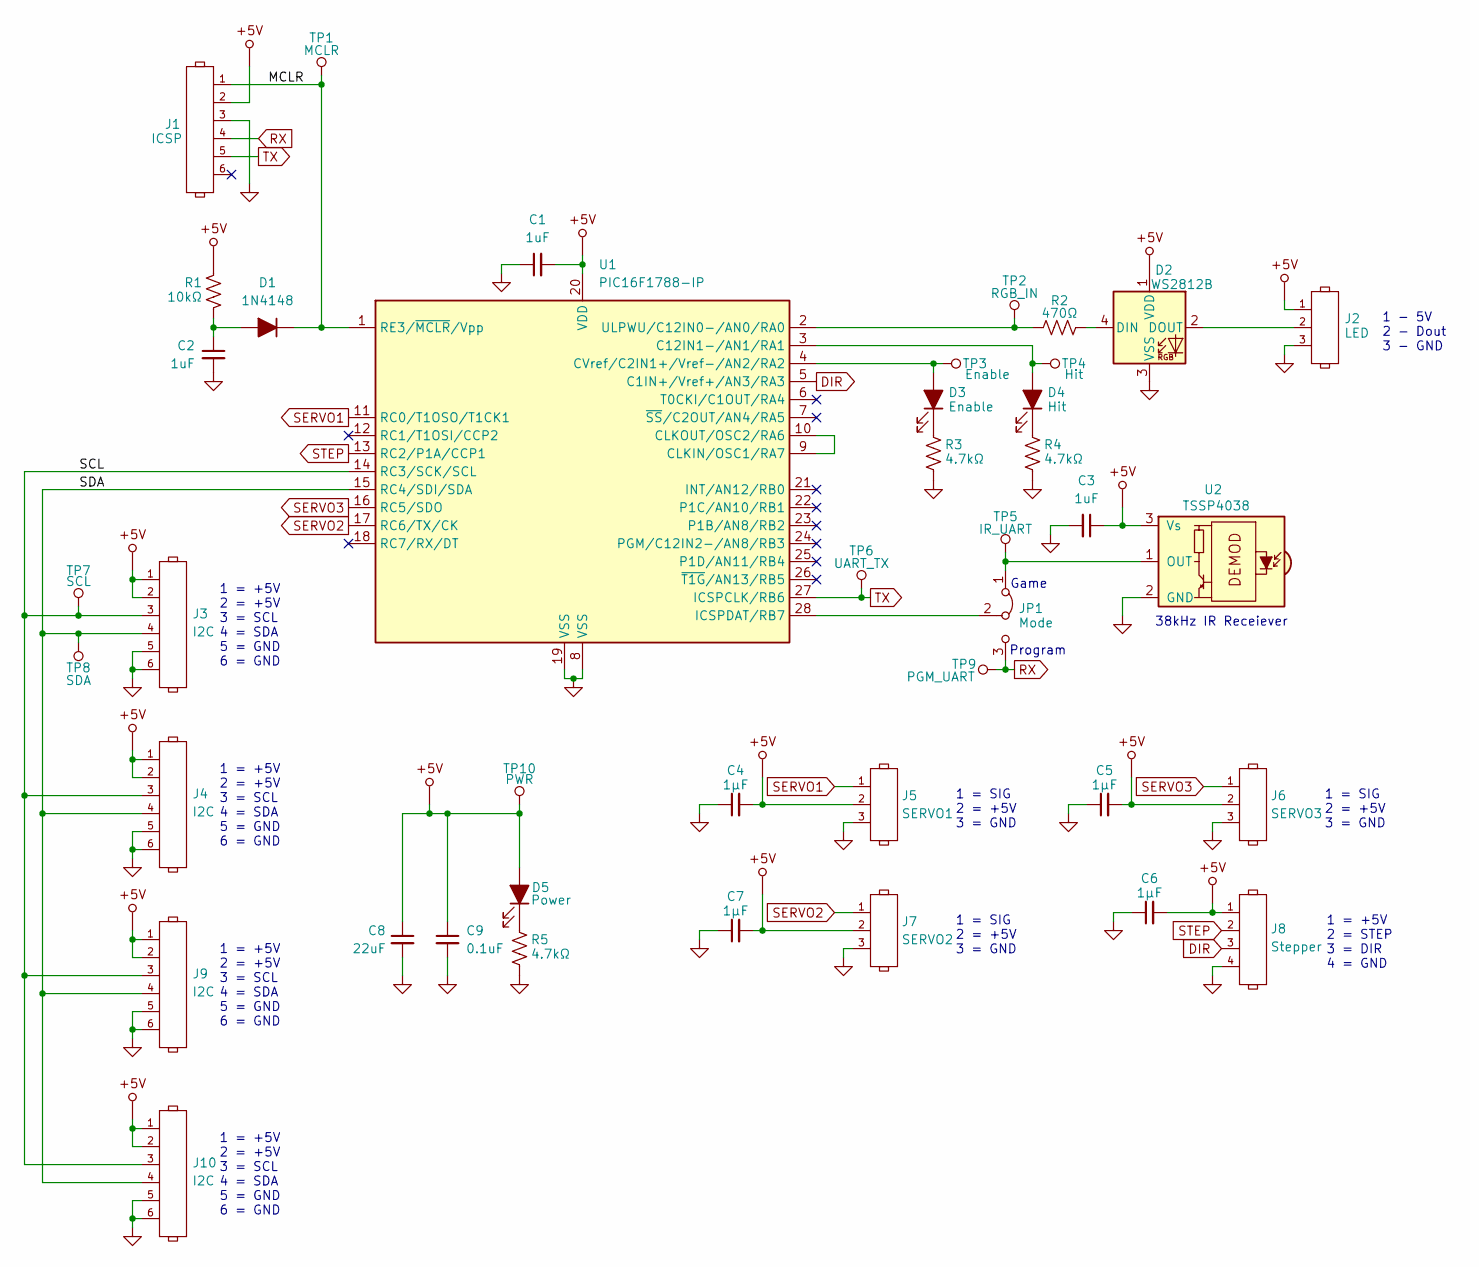
[picture p24: schematic Target_Slave.kicad_sch, Laser Arcade Slave]

Parts:
C1, C2, C3: 1uF; C_0805_2012Metric_Pad1.18x1.45mm_HandSolder
C4, C5, C6, C7: 1µF; C_0805_2012Metric_Pad1.18x1.45mm_HandSolder
C8: 22uF; C_0805_2012Metric_Pad1.18x1.45mm_HandSolder
C9: 0.1uF; C_0805_2012Metric_Pad1.18x1.45mm_HandSolder
D1: 1N4148; D_0805_2012Metric_Pad1.15x1.40mm_HandSolder
D2: WS2812B; LED_WS2812B_PLCC4_5.0x5.0mm_P3.2mm
D3: Enable; LED_0805_2012Metric_Pad1.15x1.40mm_HandSolder
D4: Hit; LED_0805_2012Metric_Pad1.15x1.40mm_HandSolder
D5: Power; LED_0805_2012Metric_Pad1.15x1.40mm_HandSolder
J1: ICSP; 1x6_100mil_Header
J2: LED; 1x3_100mil_Header_Locking
J3, J4, J9, J10: I2C; 1x6_100mil_Header
J5: SERVO1; 1x3_100mil_Header
J6: SERVO3; 1x3_100mil_Header
J7: SERVO2; 1x3_100mil_Header
J8: Stepper; 1x4_100mil_Header
JP1: Mode; 1x3_100mil_Header
R1: 10kΩ; R_0805_2012Metric_Pad1.20x1.40mm_HandSolder
R2: 470Ω; R_0805_2012Metric_Pad1.20x1.40mm_HandSolder
R3, R4, R5: 4.7kΩ; R_0805_2012Metric_Pad1.20x1.40mm_HandSolder
TP1: MCLR; 1x1_100mil_Header
TP2: RGB_IN; 1x1_100mil_Header
TP3: Enable; 1x1_100mil_Header
TP4: Hit; 1x1_100mil_Header
TP5: IR_UART; 1x1_100mil_Header
TP6: UART_TX; 1x1_100mil_Header
TP7: SCL; 1x1_100mil_Header
TP8: SDA; 1x1_100mil_Header
TP9: PGM_UART; 1x1_100mil_Header
TP10: PWR; 1x1_100mil_Header
U1: PIC16F1788-IP; SSOP-28
U2: TSSP4038; IR Receiver

Connections:
+5V: C1.2, C3.1, C4.2, C5.2, C6.2, C7.2, C8.1, C9.1, D2.1 (VDD), D5.2 (A), J1.2, J2.1, J3.1, J3.2, J4.1, J4.2, J5.2, J6.2, J7.2, J8.1, J9.1, J9.2, J10.1, J10.2, R1.1, TP10.1, U1.20 (VDD), U2.3 (Vs)
/MCLR: D1.1 (K), J1.1, TP1.1, U1.1 (RE3/~MCLR/Vpp)
/SCL: J3.3, J4.3, J9.3, J10.3, TP7.1, U1.14 (RC3/SCK/SCL)
/SDA: J3.4, J4.4, J9.4, J10.4, TP8.1, U1.15 (RC4/SDI/SDA)
DIR: J8.3, U1.5 (C1IN+/Vref+/AN3/RA3)
GND: C1.1, C2.2, C3.2, C4.1, C5.1, C6.1, C7.1, C8.2, C9.2, D2.3 (VSS), J1.3, J2.3, J3.5, J3.6, J4.5, J4.6, J5.3, J6.3, J7.3, J8.4, J9.5, J9.6, J10.5, J10.6, R3.2, R4.2, R5.2, U1.8 (VSS), U1.19 (VSS), U2.2 (GND)
unnamed: C2.1, D1.2 (A), R1.2
unnamed: D2.4 (DIN), R2.2
unnamed: D2.2 (DOUT), J2.2
unnamed: D3.2 (A), TP3.1, U1.4 (CVref/C2IN1+/Vref-/AN2/RA2)
unnamed: D3.1 (K), R3.1
unnamed: D4.2 (A), TP4.1, U1.3 (C12IN1-/AN1/RA1)
unnamed: D4.1 (K), R4.1
unnamed: D5.1 (K), R5.1
unnamed: JP1.1 (A), TP5.1, U2.1 (OUT)
unnamed: JP1.2 (C), U1.28 (ICSPDAT/RB7)
unnamed: U1.9 (CLKIN/OSC1/RA7), U1.10 (CLKOUT/OSC2/RA6)
unnamed: R2.1, TP2.1, U1.2 (ULPWU/C12IN0-/AN0/RA0)
RX: J1.4, JP1.3 (B), TP9.1
SERVO1: J5.1, U1.11 (RC0/T1OSO/T1CK1)
SERVO2: J7.1, U1.17 (RC6/TX/CK)
SERVO3: J6.1, U1.16 (RC5/SDO)
STEP: J8.2, U1.13 (RC2/P1A/CCP1)
TX: J1.5, TP6.1, U1.27 (ICSPCLK/RB6)

Notes on the sheet:
1 = +5V 2 = STEP 3 = DIR 4 = GND
1 = +5V 2 = +5V 3 = SCL 4 = SDA 5 = GND 6 = GND
Program
1 = SIG 2 = +5V 3 = GND
1 - 5V 2 - Dout 3 - GND
Game
38kHz IR Receiever

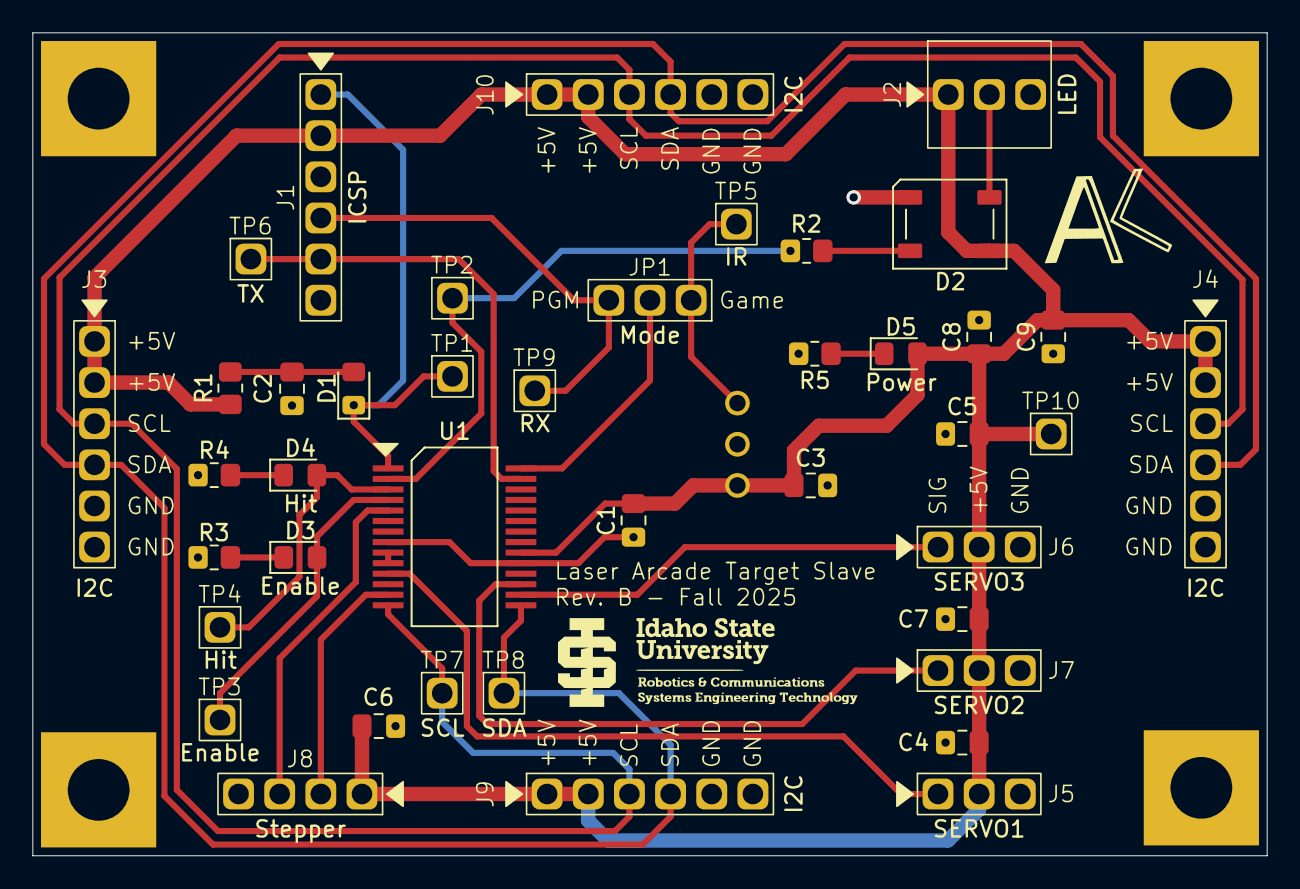
[picture p25: board Target_Slave.kicad_pcb from above]

Board: 2 copper layers, 76.2 x 50.8 mm, 42 parts (1 on the bottom side), 24 nets.
