TheGoldenPorkchop/RCETLaserArcade/KiCad/Target_Master/Target.kicad_pcb

## KiCad design KiCad/Target_Master/Target.kicad_pcb (2025-11-17)

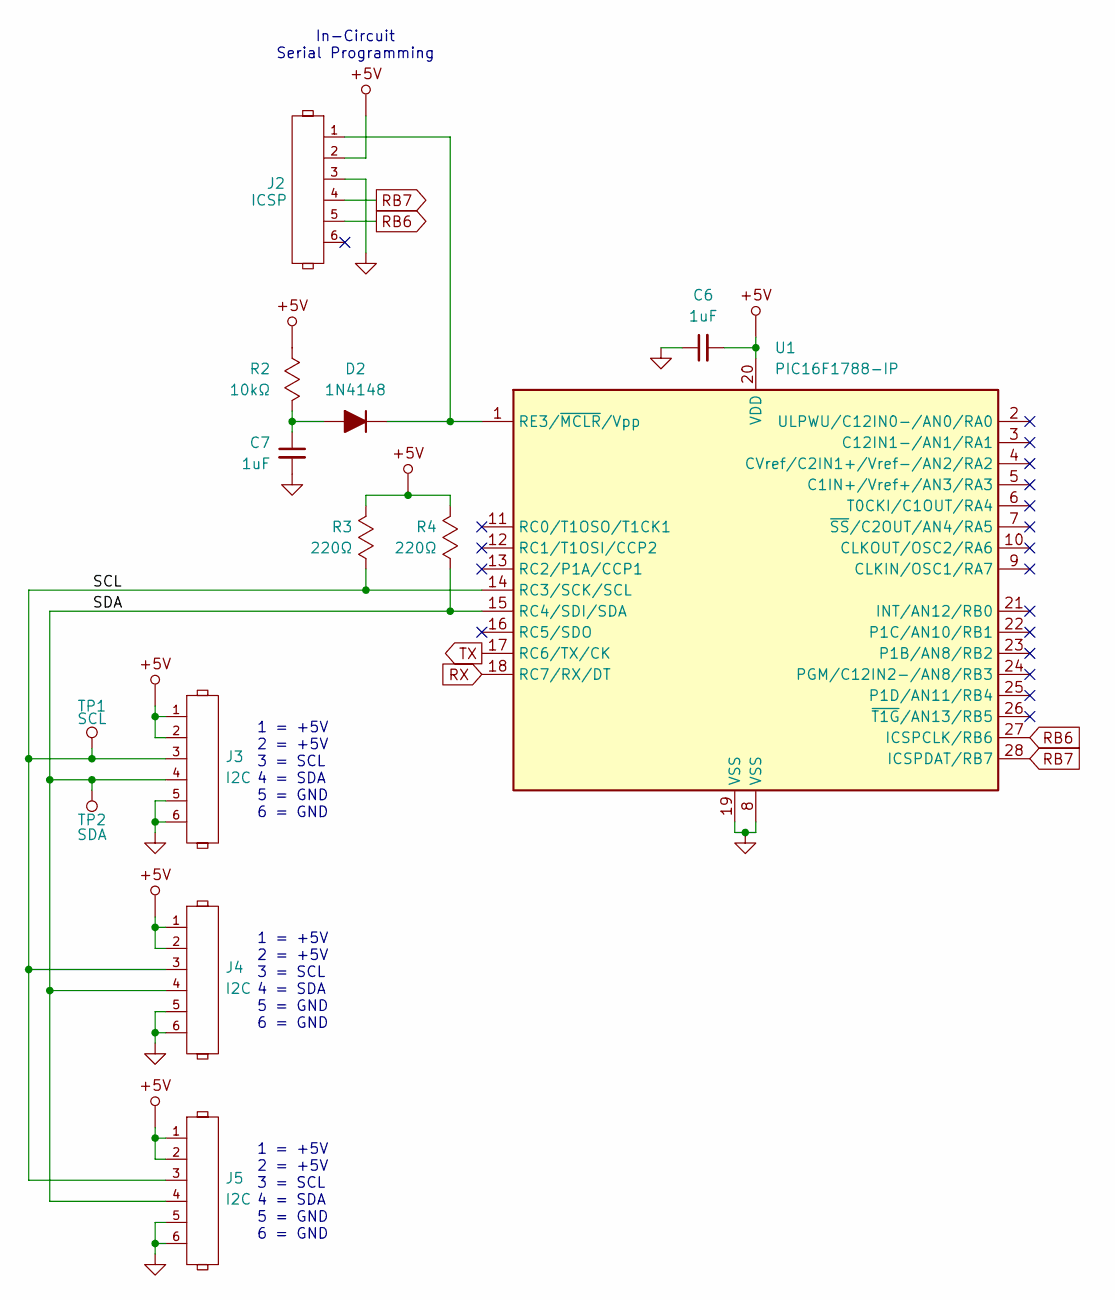
[picture p26: schematic Target_Master.kicad_sch, Laser Arcade Master]

Parts:
C6, C7: 1uF; C_0805_2012Metric_Pad1.18x1.45mm_HandSolder
D2: 1N4148; D_0805_2012Metric_Pad1.15x1.40mm_HandSolder
J2: ICSP; 1x6_100mil_Header
J3, J4, J5: I2C; 1x6_100mil_Header
R2: 10kΩ; R_0805_2012Metric_Pad1.20x1.40mm_HandSolder
R3, R4: 220Ω; R_0805_2012Metric_Pad1.20x1.40mm_HandSolder
TP1: SCL; 1x1_100mil_Header
TP2: SDA; 1x1_100mil_Header
U1: PIC16F1788-IP; SSOP-28

Connections:
+5V: C6.2, J2.2, J3.1, J3.2, J4.1, J4.2, J5.1, J5.2, R2.2, R3.1, R4.1, U1.20 (VDD); also elsewhere on the board
/Master/SCL: J3.3, J4.3, J5.3, R3.2, TP1.1, U1.14 (RC3/SCK/SCL)
/Master/SDA: J3.4, J4.4, J5.4, R4.2, TP2.1, U1.15 (RC4/SDI/SDA)
GND: C6.1, C7.2, J2.3, J3.5, J3.6, J4.5, J4.6, J5.5, J5.6, U1.8 (VSS), U1.19 (VSS); also elsewhere on the board
unnamed: C7.1, D2.2 (A), R2.1
unnamed: D2.1 (K), J2.1, U1.1 (RE3/~MCLR/Vpp)
RB6: J2.5, U1.27 (ICSPCLK/RB6)
RB7: J2.4, U1.28 (ICSPDAT/RB7)
RX: U1.18 (RC7/RX/DT); also elsewhere on the board
TX: U1.17 (RC6/TX/CK); also elsewhere on the board

Notes on the sheet:
In-Circuit Serial Programming
1 = +5V 2 = +5V 3 = SCL 4 = SDA 5 = GND 6 = GND

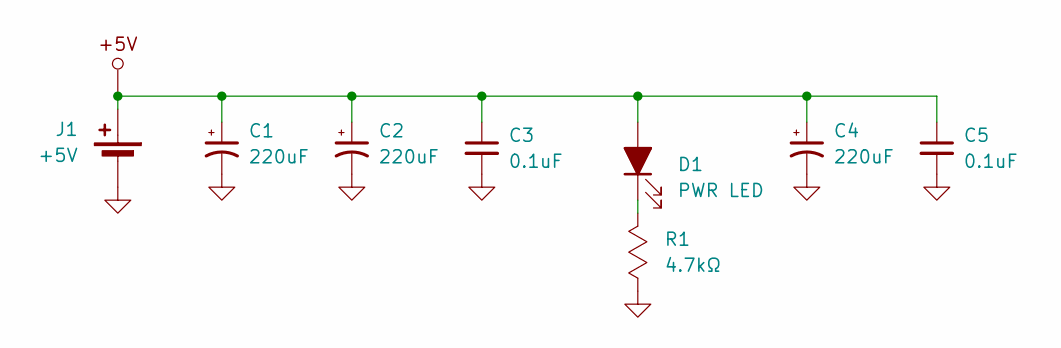
[picture p27: schematic Target_Power.kicad_sch, Laser Arcade Master]

Parts:
C1, C2, C4: 220uF; CP_Radial_D6.3mm_P2.50mm
C3, C5: 0.1uF; C_0805_2012Metric_Pad1.18x1.45mm_HandSolder
D1: PWR LED; LED_0805_2012Metric_Pad1.15x1.40mm_HandSolder
J1: +5V; AMASS_XT30PW-M_1x02_P2.50mm_Horizontal
R1: 4.7kΩ; R_0805_2012Metric_Pad1.20x1.40mm_HandSolder

Connections:
+5V: C1.1, C2.1, C3.1, C4.1, C5.1, D1.2 (A), J1.1 (+); also elsewhere on the board
GND: C1.2, C2.2, C3.2, C4.2, C5.2, J1.2 (-), R1.1; also elsewhere on the board
unnamed: D1.1 (K), R1.2

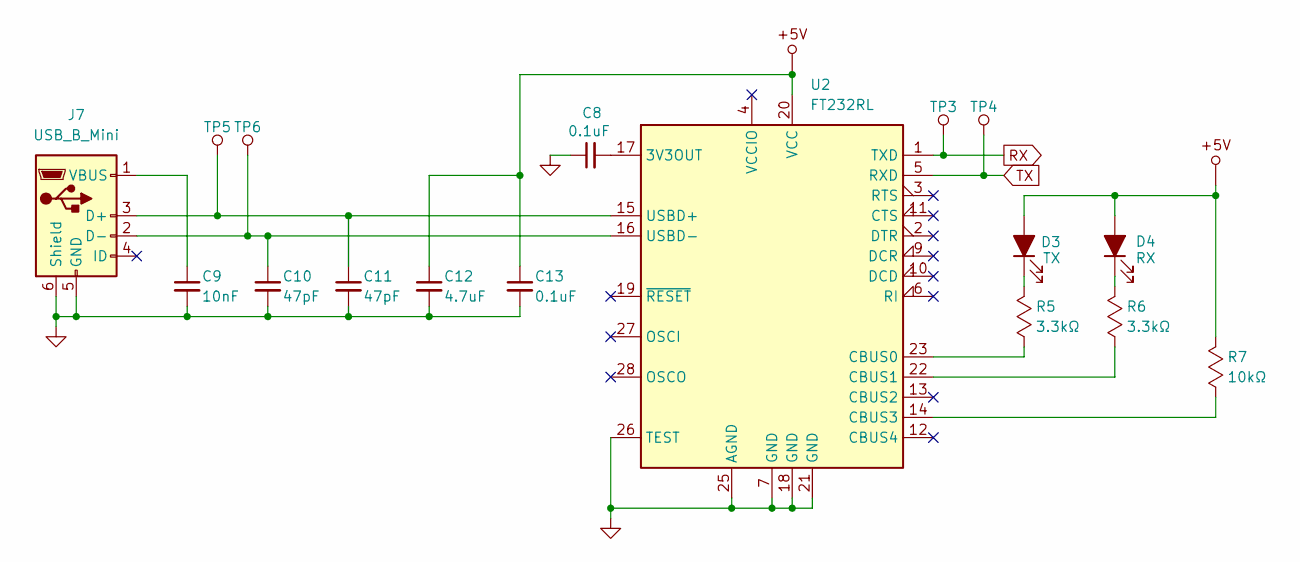
[picture p28: schematic UART.kicad_sch, Laser Arcade Master]

Parts:
C8, C13: 0.1uF; C_0805_2012Metric_Pad1.18x1.45mm_HandSolder
C9: 10nF; C_0805_2012Metric_Pad1.18x1.45mm_HandSolder
C10, C11: 47pF; C_0805_2012Metric_Pad1.18x1.45mm_HandSolder
C12: 4.7uF; C_0805_2012Metric_Pad1.18x1.45mm_HandSolder
D3: TX; LED_0805_2012Metric_Pad1.15x1.40mm_HandSolder
D4: RX; LED_0805_2012Metric_Pad1.15x1.40mm_HandSolder
J7: USB_B_Mini; USB_Micro-B_Amphenol
R5, R6: 3.3kΩ; R_0805_2012Metric_Pad1.20x1.40mm_HandSolder
R7: 10kΩ; R_0805_2012Metric_Pad1.20x1.40mm_HandSolder
TP3, TP4, TP5, TP6: 1x1_100mil_Header
U2: FT232RL; SSOP-28

Connections:
+5V: C12.1, C13.1, D3.2 (A), D4.2 (A), R7.2, U2.20 (VCC); also elsewhere on the board
GND: C8.1, C9.2, C10.2, C11.2, C12.2, C13.2, J7.5 (GND), J7.6 (Shield), U2.7 (GND), U2.18 (GND), U2.21 (GND), U2.25 (AGND), U2.26 (TEST); also elsewhere on the board
unnamed: D3.1 (K), R5.2
unnamed: D4.1 (K), R6.2
unnamed: C11.1, J7.3 (D+), TP5.1, U2.15 (USBD+)
unnamed: C10.1, J7.2 (D-), TP6.1, U2.16 (USBD-)
unnamed: C9.1, J7.1 (VBUS)
unnamed: C8.2, U2.17 (3V3OUT)
unnamed: R5.1, U2.23 (CBUS0)
unnamed: R6.1, U2.22 (CBUS1)
unnamed: R7.1, U2.14 (CBUS3)
RX: TP3.1, U2.1 (TXD); also elsewhere on the board
TX: TP4.1, U2.5 (RXD); also elsewhere on the board

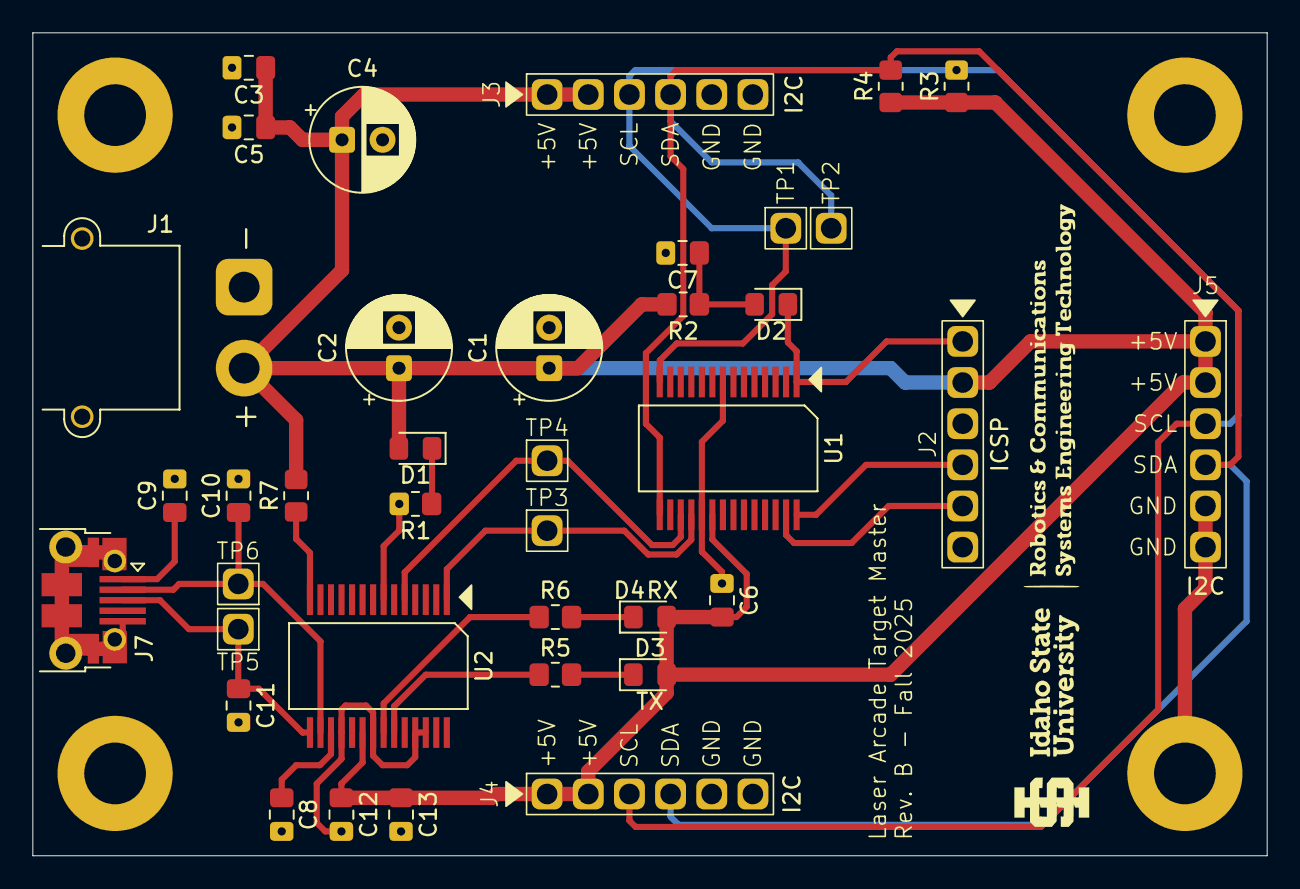
[picture p29: board Target.kicad_pcb from above]

Board: 2 copper layers, 76.2 x 50.8 mm, 38 parts (0 on the bottom side), 20 nets.
