TheGoldenPorkchop/RCETLaserArcade/KiCad/Blaster/Project.kicad_pcb

## KiCad design KiCad/Blaster/Project.kicad_pcb (2025-11-14)

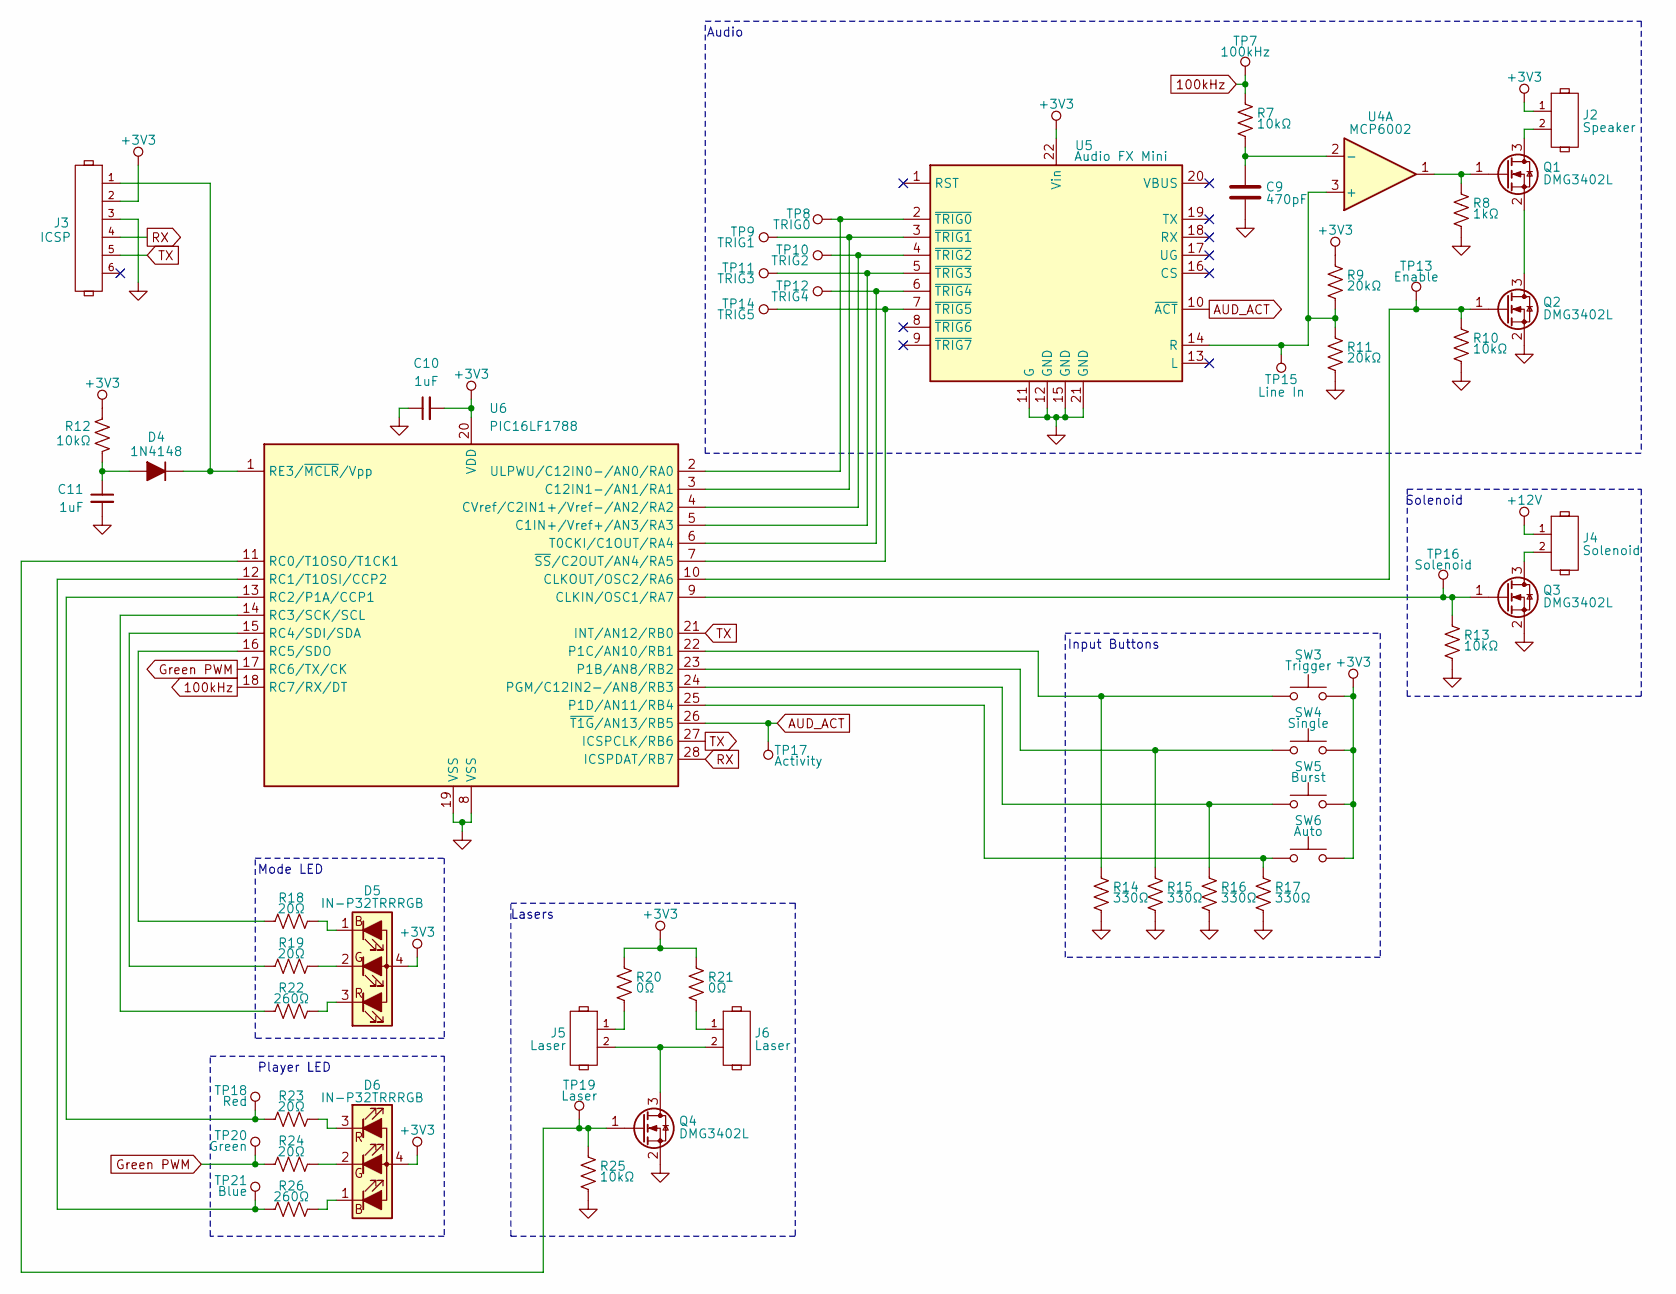
[picture p30: schematic Microcontroller.kicad_sch, Laser Arcade Blaster]

Parts:
C9: 470pF; C_0805_2012Metric_Pad1.18x1.45mm_HandSolder
C10, C11: 1uF; C_0805_2012Metric_Pad1.18x1.45mm_HandSolder
D4: 1N4148; D_0805_2012Metric_Pad1.15x1.40mm_HandSolder
D5, D6: IN-P32TRRRGB
J2: Speaker; 1x2_100mil_Header_Locking
J3: ICSP; 1x6_100mil_Header
J4: Solenoid; 1x2_100mil_Header_Locking
J5, J6: Laser; 1x2_100mil_Header_Locking
Q1, Q2, Q3, Q4: DMG3402L; SOT-23
R7, R10, R12, R13, R25: 10kΩ; R_0805_2012Metric_Pad1.20x1.40mm_HandSolder
R8: 1kΩ; R_0805_2012Metric_Pad1.20x1.40mm_HandSolder
R9, R11: 20kΩ; R_0805_2012Metric_Pad1.20x1.40mm_HandSolder
R14, R15, R16, R17: 330Ω; R_0805_2012Metric_Pad1.20x1.40mm_HandSolder
R18, R19, R23, R24: 20Ω; R_0805_2012Metric_Pad1.20x1.40mm_HandSolder
R20, R21: 0Ω; R_0805_2012Metric_Pad1.20x1.40mm_HandSolder
R22, R26: 260Ω; R_0805_2012Metric_Pad1.20x1.40mm_HandSolder
SW3: Trigger; SW_Tactile_SPST_Angled_PTS645Vx31-2LFS
SW4: Single; SW_PUSH_6mm_H5mm
SW5: Burst; SW_PUSH_6mm_H5mm
SW6: Auto; SW_PUSH_6mm_H5mm
TP7: 100kHz; 1x1_100mil_Header
TP8: TRIG0; 1x1_100mil_Header
TP9: TRIG1; 1x1_100mil_Header
TP10: TRIG2; 1x1_100mil_Header
TP11: TRIG3; 1x1_100mil_Header
TP12: TRIG4; 1x1_100mil_Header
TP13: Enable; 1x1_100mil_Header
TP14: TRIG5; 1x1_100mil_Header
TP15: Line In; 1x1_100mil_Header
TP16: Solenoid; 1x1_100mil_Header
TP17: Activity; 1x1_100mil_Header
TP18: Red; 1x1_100mil_Header
TP19: Laser; 1x1_100mil_Header
TP20: Green; 1x1_100mil_Header
TP21: Blue; 1x1_100mil_Header
U4: MCP6002; SOIC-8_3.9x4.9mm_P1.27mm
U5: Audio FX Mini; Adafruit_AudioFXMini
U6: PIC16LF1788; SSOP-28

Connections:
100kHz: R7.1, TP7.1, U6.18 (RC7/RX/DT)
+3V3: C10.2, D5.4 (A), D6.4 (A), J2.1, J3.2, R9.1, R12.1, R20.1, R21.1, SW3.2, SW4.2, SW5.2, SW6.2, U5.22 (Vin), U6.20 (VDD); also elsewhere on the board
+12V: J4.1; also elsewhere on the board
AUD_ACT: TP17.1, U5.10 (~ACT), U6.26 (~T1G/AN13/RB5)
GND: C9.2, C10.1, C11.2, J3.3, Q2.2 (S), Q3.2 (S), Q4.2 (S), R8.2, R10.2, R11.2, R13.2, R14.2, R15.2, R16.2, R17.2, R25.2, U5.11 (G), U5.12 (GND), U5.15 (GND), U5.21 (GND), U6.8 (VSS), U6.19 (VSS); also elsewhere on the board
Green PWM: R24.1, TP20.1, U6.17 (RC6/TX/CK)
unnamed: C11.1, D4.2 (A), R12.2
unnamed: D4.1 (K), J3.1, U6.1 (RE3/~MCLR/Vpp)
unnamed: D5.1 (BK), R18.2
unnamed: D5.2 (GK), R19.2
unnamed: D5.3 (RK), R22.2
unnamed: D6.1 (BK), R26.2
unnamed: D6.2 (GK), R24.2
unnamed: D6.3 (RK), R23.2
unnamed: J5.1, R20.2
unnamed: J6.1, R21.2
unnamed: J2.2, Q1.3 (D)
unnamed: Q1.1 (G), R8.1, U4.1
unnamed: Q1.2 (S), Q2.3 (D)
unnamed: Q2.1 (G), R10.1, TP13.1, U6.10 (CLKOUT/OSC2/RA6)
unnamed: J4.2, Q3.3 (D)
unnamed: Q3.1 (G), R13.1, TP16.1, U6.9 (CLKIN/OSC1/RA7)
unnamed: J5.2, J6.2, Q4.3 (D)
unnamed: Q4.1 (G), R25.1, TP19.1, U6.11 (RC0/T1OSO/T1CK1)
unnamed: R9.2, R11.1, TP15.1, U4.3 (+), U5.14 (R)
unnamed: C9.1, R7.2, U4.2 (-)
unnamed: TP8.1, U5.2 (~TRIG0), U6.2 (ULPWU/C12IN0-/AN0/RA0)
unnamed: TP9.1, U5.3 (~TRIG1), U6.3 (C12IN1-/AN1/RA1)
unnamed: TP10.1, U5.4 (~TRIG2), U6.4 (CVref/C2IN1+/Vref-/AN2/RA2)
unnamed: TP11.1, U5.5 (~TRIG3), U6.5 (C1IN+/Vref+/AN3/RA3)
unnamed: TP12.1, U5.6 (~TRIG4), U6.6 (T0CKI/C1OUT/RA4)
unnamed: TP14.1, U5.7 (~TRIG5), U6.7 (~SS/C2OUT/AN4/RA5)
unnamed: R15.1, SW4.1, U6.23 (P1B/AN8/RB2)
unnamed: R14.1, SW3.1, U6.22 (P1C/AN10/RB1)
unnamed: R17.1, SW6.1, U6.25 (P1D/AN11/RB4)
unnamed: R16.1, SW5.1, U6.24 (PGM/C12IN2-/AN8/RB3)
unnamed: R26.1, TP21.1, U6.12 (RC1/T1OSI/CCP2)
unnamed: R23.1, TP18.1, U6.13 (RC2/P1A/CCP1)
unnamed: R22.1, U6.14 (RC3/SCK/SCL)
unnamed: R19.1, U6.15 (RC4/SDI/SDA)
unnamed: R18.1, U6.16 (RC5/SDO)
RX: J3.4, U6.28 (ICSPDAT/RB7); also elsewhere on the board
TX: J3.5, U6.21 (INT/AN12/RB0), U6.27 (ICSPCLK/RB6); also elsewhere on the board

Notes on the sheet:
Solenoid
Mode LED
Player LED
Lasers
Input Buttons
Audio

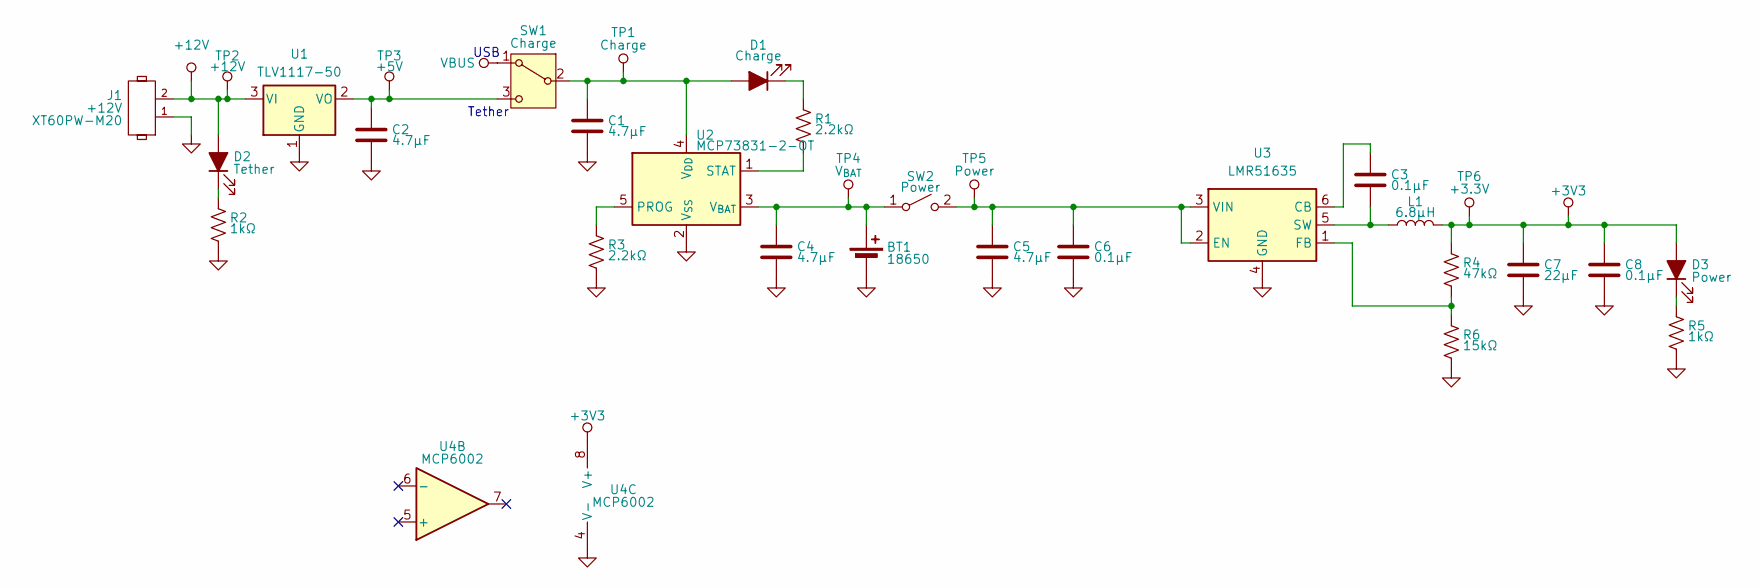
[picture p31: schematic Blaster_Power.kicad_sch, Laser Arcade Blaster]

Parts:
BT1: 18650; BatteryHolder_Keystone_1042_1x18650
C1, C2, C4, C5: 4.7µF; C_0805_2012Metric_Pad1.18x1.45mm_HandSolder
C3, C6, C8: 0.1µF; C_0805_2012Metric_Pad1.18x1.45mm_HandSolder
C7: 22µF; C_0805_2012Metric_Pad1.18x1.45mm_HandSolder
D1: Charge; LED_0805_2012Metric_Pad1.15x1.40mm_HandSolder
D2: Tether; LED_0805_2012Metric_Pad1.15x1.40mm_HandSolder
D3: Power; LED_0805_2012Metric_Pad1.15x1.40mm_HandSolder
J1: +12V; AMASS_XT60PW-M_1x02_P7.20mm_Horizontal
L1: 6.8µH; LA Blaster Power Inductor
R1, R3: 2.2kΩ; R_0805_2012Metric_Pad1.20x1.40mm_HandSolder
R2, R5: 1kΩ; R_0805_2012Metric_Pad1.20x1.40mm_HandSolder
R4: 47kΩ; R_0805_2012Metric_Pad1.20x1.40mm_HandSolder
R6: 15kΩ; R_0805_2012Metric_Pad1.20x1.40mm_HandSolder
SW1: Charge; T80-T
SW2: Power; LA Blaster Power Switch
TP1: Charge; 1x1_100mil_Header
TP2: +12V; 1x1_100mil_Header
TP3: +5V; 1x1_100mil_Header
TP4: V_{BAT}; 1x1_100mil_Header
TP5: Power; 1x1_100mil_Header
TP6: +3.3V; 1x1_100mil_Header
U1: TLV1117-50; SOT-223-3_TabPin2
U2: MCP73831-2-OT; SOT-23-5_HandSoldering
U3: LMR51635; SOT-23-6_Handsoldering
U4: MCP6002; SOIC-8_3.9x4.9mm_P1.27mm

Connections:
+3V3: C7.1, C8.1, D3.2 (A), L1.2, R4.1, TP6.1, U4.8 (V+); also elsewhere on the board
+12V: D2.2 (A), J1.2, TP2.1, U1.3 (VI); also elsewhere on the board
GND: BT1.2 (-), C1.2, C2.2, C4.2, C5.2, C6.2, C7.2, C8.2, J1.1, R2.2, R3.2, R5.2, R6.2, U1.1 (GND), U2.2 (V_{SS}), U3.4 (GND), U4.4 (V-); also elsewhere on the board
unnamed: BT1.1 (+), C4.1, SW2.1 (A), TP4.1, U2.3 (V_{BAT})
unnamed: C1.1, D1.2 (A), SW1.2 (B), TP1.1, U2.4 (V_{DD})
unnamed: D1.1 (K), R1.1
unnamed: D2.1 (K), R2.1
unnamed: D3.1 (K), R5.1
unnamed: C2.1, SW1.3 (C), TP3.1, U1.2 (VO)
unnamed: C5.1, C6.1, SW2.2 (B), TP5.1, U3.2 (EN), U3.3 (VIN)
unnamed: R3.1, U2.5 (PROG)
unnamed: R1.2, U2.1 (STAT)
unnamed: C3.1, U3.6 (CB)
unnamed: R4.2, R6.1, U3.1 (FB)
unnamed: C3.2, L1.1, U3.5 (SW)
VBUS: SW1.1 (A); also elsewhere on the board

Notes on the sheet:
Tether
USB

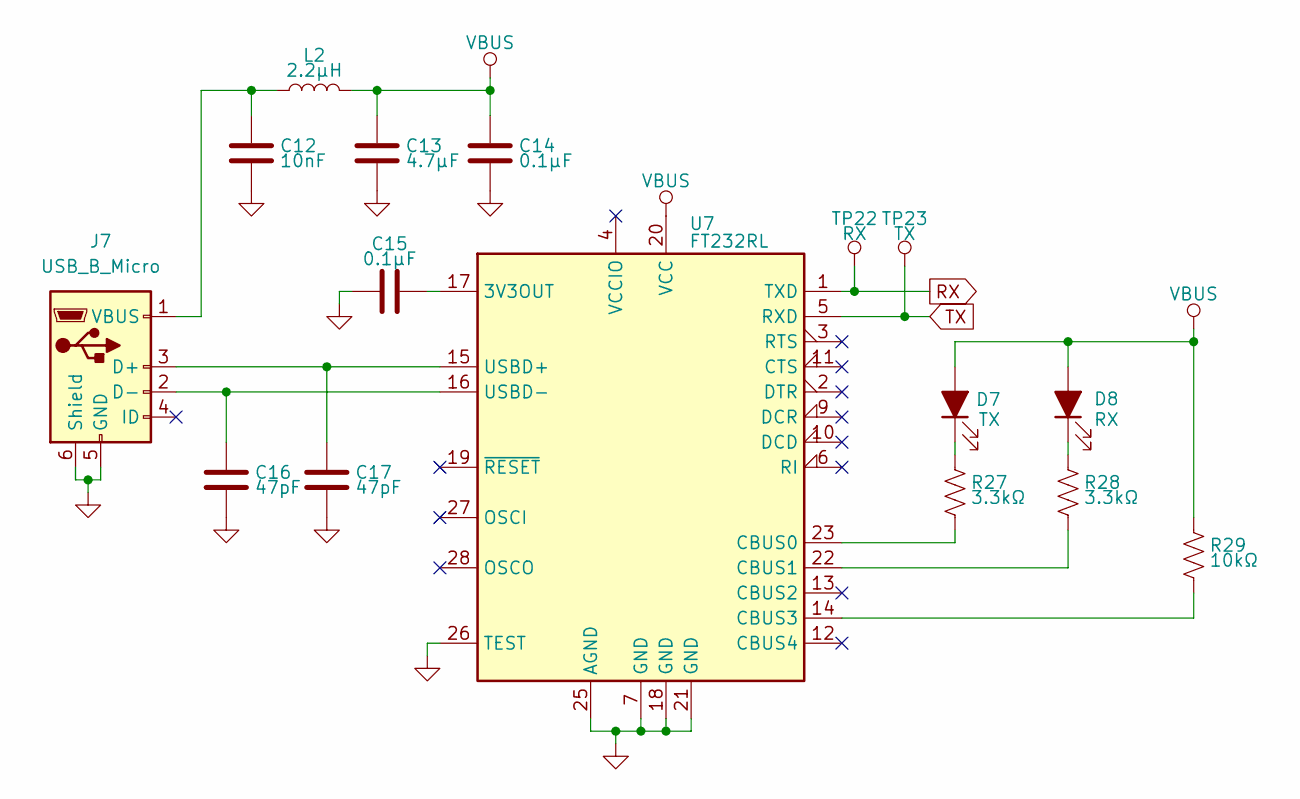
[picture p32: schematic Communications.kicad_sch, Laser Arcade Blaster]

Parts:
C12: 10nF; C_0805_2012Metric_Pad1.18x1.45mm_HandSolder
C13: 4.7µF; C_0805_2012Metric_Pad1.18x1.45mm_HandSolder
C14, C15: 0.1µF; C_0805_2012Metric_Pad1.18x1.45mm_HandSolder
C16, C17: 47pF; C_0805_2012Metric_Pad1.18x1.45mm_HandSolder
D7: TX; LED_0805_2012Metric_Pad1.15x1.40mm_HandSolder
D8: RX; LED_0805_2012Metric_Pad1.15x1.40mm_HandSolder
J7: USB_B_Micro; USB_Micro-B_Amphenol
L2: 2.2µH; L_0805_2012Metric_Pad1.15x1.40mm_HandSolder
R27, R28: 3.3kΩ; R_0805_2012Metric_Pad1.20x1.40mm_HandSolder
R29: 10kΩ; R_0805_2012Metric_Pad1.20x1.40mm_HandSolder
TP22: RX; 1x1_100mil_Header
TP23: TX; 1x1_100mil_Header
U7: FT232RL; SSOP-28

Connections:
GND: C12.2, C13.2, C14.2, C15.1, C16.2, C17.2, J7.5 (GND), J7.6 (Shield), U7.7 (GND), U7.18 (GND), U7.21 (GND), U7.25 (AGND), U7.26 (TEST); also elsewhere on the board
unnamed: D7.1 (K), R27.1
unnamed: D8.1 (K), R28.1
unnamed: C17.1, J7.3 (D+), U7.15 (USBD+)
unnamed: C16.1, J7.2 (D-), U7.16 (USBD-)
unnamed: C12.1, J7.1 (VBUS), L2.1
unnamed: C15.2, U7.17 (3V3OUT)
unnamed: R27.2, U7.23 (CBUS0)
unnamed: R28.2, U7.22 (CBUS1)
unnamed: R29.2, U7.14 (CBUS3)
RX: TP22.1, U7.1 (TXD); also elsewhere on the board
TX: TP23.1, U7.5 (RXD); also elsewhere on the board
VBUS: C13.1, C14.1, D7.2 (A), D8.2 (A), L2.2, R29.1, U7.20 (VCC); also elsewhere on the board
