TheGoldenPorkchop/RCETLaserArcade/KiCad/Blaster/Project.kicad_pcb

## KiCad design KiCad/Blaster/Project.kicad_pcb (continued)

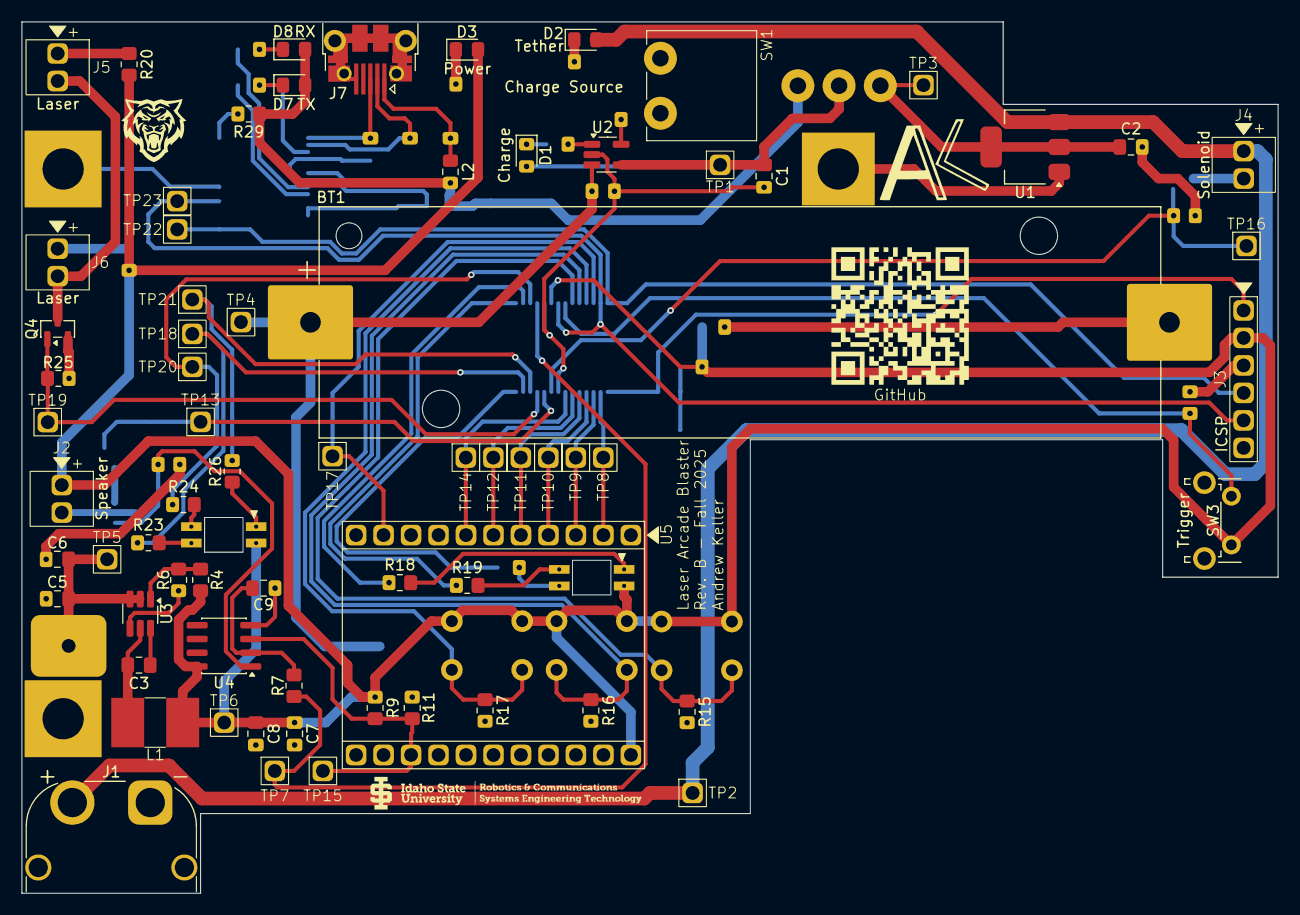
[picture p33: board Project.kicad_pcb from above]

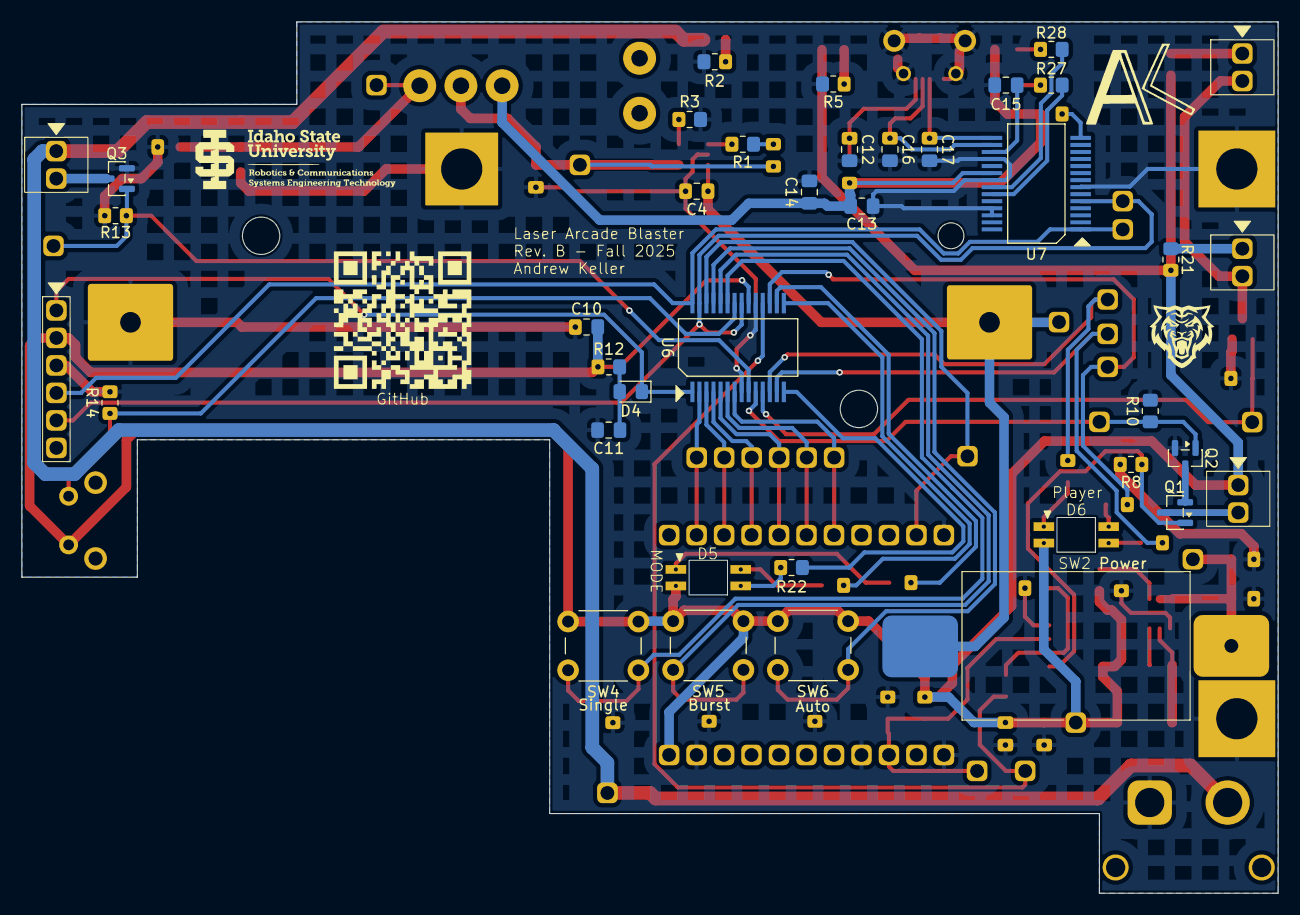
[picture p34: board Project.kicad_pcb from below]

Board: 2 copper layers, 116.1 x 80.5 mm, 104 parts (34 on the bottom side), 65 nets.
