TheGoldenPorkchop/RCETLaserArcade/(commit log)

2025-10-28 Ignore KiCad auto save file
2025-10-28 Add servo and stepper outputs to slave schematic and increase number of power pins at I2C headers
    [Target_Slave.kicad_sch]
2025-10-28 Print updated slave schematic to PDF
    [Target_Slave.kicad_sch]
2025-11-03 Add MCP73831 Lipo charge IC datasheet
2025-11-03 Blaster schematic update PIC, solenoid, and FX Mini
    [Blaster_Bottom.kicad_sch, Blaster_Power.kicad_sch, Blaster_Top.kicad_sch, Project.kicad_sch]
2025-11-04 Updated Blaster Microcontroller Schematic
    [Blaster_Bottom.kicad_sch, Blaster_Top.kicad_sch, Communications.kicad_sch, Microcontroller.kicad_sch, Project.kicad_sch]
2025-11-04 Add blaster MOSFET datasheet
2025-11-04 Blaster Power and Communications schematic updates. Add Revision B schematic
    [Blaster_Power.kicad_sch, Communications.kicad_sch, Microcontroller.kicad_sch]
2025-11-04 Init Target Jumper
    [Target_Jumper.kicad_pcb, Target_Jumper.kicad_sch]
2025-11-04 Target Jumper Schematics
    [Target_Jumper.kicad_sch]
2025-11-05 Complete Target Jumper PCB
    [Target_Jumper.kicad_pcb, Target_Jumper.kicad_sch]
2025-11-06 Rev B Target Slave PCB design
    [Target_Slave.kicad_pcb, Target_Slave.kicad_sch]
2025-11-06 Plot Target Slave Gerbers
    [Target_Slave-B_Cu.gbr, Target_Slave-B_Mask.gbr, Target_Slave-B_Silkscreen.gbr, Target_Slave-Edge_Cuts.gbr, Target_Slave-F_Cu.gbr, Target_Slave-F_Mask.gbr, Target_Slave-F_Silkscreen.gbr, Target_Slave-NPTH.drl]
2025-11-06 Plot Target Jumper PCB and Schematic
    [Target_Jumper-B_Cu.gbr, Target_Jumper-B_Mask.gbr, Target_Jumper-B_Paste.gbr, Target_Jumper-B_Silkscreen.gbr, Target_Jumper-Edge_Cuts.gbr, Target_Jumper-F_Cu.gbr, Target_Jumper-F_Mask.gbr, Target_Jumper-F_Paste.gbr]
2025-11-07 Re-export gerbers
    [Target_Jumper-B_Cu.gbr, Target_Jumper-B_Mask.gbr, Target_Jumper-B_Paste.gbr, Target_Jumper-B_Silkscreen.gbr, Target_Jumper-Edge_Cuts.gbr, Target_Jumper-F_Cu.gbr, Target_Jumper-F_Mask.gbr, Target_Jumper-F_Paste.gbr]
2025-11-12 Assign blaster footprints, Create Blaster PCB Outline
    [Blaster_Power.kicad_sch, Communications.kicad_sch, Microcontroller.kicad_sch, Project.kicad_pcb, Target_Jumper.kicad_pcb]
2025-11-12 Assign blaster PCB Footprints
    [Blaster_Power.kicad_sch, Microcontroller.kicad_sch, Project.kicad_pcb]
2025-11-12 Place major components on PCB
    [Project.kicad_pcb]
2025-11-14 Complete Blaster PCB layout and traces
    [Blaster_Power.kicad_sch, Communications.kicad_sch, Microcontroller.kicad_sch, Project.kicad_pcb]
2025-11-14 Update blaster schematic date and print
    [Blaster_Power.kicad_sch, Communications.kicad_sch, Microcontroller.kicad_sch, Project.kicad_sch]
2025-11-14 Complete Blaster PCB Export
    [Project-B_Cu.gbr, Project-B_Mask.gbr, Project-B_Paste.gbr, Project-B_Silkscreen.gbr, Project-Edge_Cuts.gbr, Project-F_Cu.gbr, Project-F_Mask.gbr, Project-F_Paste.gbr]
2025-11-14 Move Master Rev A files to Rev A folder
    [Master BOM.csv, master.csv]
2025-11-17 Completed Target Master Rev. B PCB
    [Target.kicad_pcb, Target.kicad_sch, Target_Master.kicad_sch, Target_Power.kicad_sch, UART.kicad_sch]
2025-11-17 Completed Target Master PCB, export gerbers and views
    [Target-B_Cu.gbr, Target-B_Mask.gbr, Target-B_Silkscreen.gbr, Target-Edge_Cuts.gbr, Target-F_Cu.gbr, Target-F_Mask.gbr, Target-F_Silkscreen.gbr, Target-NPTH.drl]
2025-11-17 Export Blaster 3D Image, Minor text changes on Master PCB
    [Target.kicad_pcb]
2025-11-17 Export Target Slave PCB Images, update date
    [Target_Slave.kicad_pcb, Target_Slave.kicad_sch]
2025-11-17 Add WS2812B LED Protocol include file
2025-11-18 Player LED PWM configuration
2025-11-19 Add Laser Configuration
2025-11-19 Change fire mode, layout interrupt on change ISR
2025-11-20 Solenoid activation with fire, move blaster fire into subroutine
2025-11-20 Added UART Controller
2025-11-21 -Added Fields/State section to use for the device verification process later -Added some custom events to be used later -Reformatted comments (Headers & process blocks) -Started creating the Connect 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
2025-12-02 -Added Device Verfication
2025-12-07 Exporting pcb images
    [Target_Jumper.kicad_pcb]
2025-12-07 Add DMG3402L MOSFET datasheet to references
2025-12-07 Blaster UART commands, aligning audio with solenoid
2025-12-08 Sends a to UART after a successfull WRITE_I2C AND WRITE_COLOR_I2C command
2025-12-10 Slave responds to UART and I2C
2025-12-10 Reduce LED flash speed when hit
2025-12-10 there was a page turn apparently. Added one NOP and the I2C Read now sends the data to UART
2025-12-11 Read settings UART command, start of I2C color change command
2025-12-11 Revert "Read settings UART command, start of I2C color change command"
    This reverts commit f1f14a76106aaaaaa9ff06ae6aa145f69a44b6fe.
2025-12-12 Assembly: added a way to clear timeout flag. VB: added a player class to update colors and small ui development
2025-12-14 Updated servo positions, hit and enable indicators, not hit while disabled, file headers
2025-12-15 Remove lines in enable/disable target subroutines to activate correct number of LEDs
2026-03-10 Final Commit
    [Blaster_Power.kicad_sch, Communications.kicad_sch, Microcontroller.kicad_sch, Project.kicad_sch, Target.kicad_sch, Target_Jumper.kicad_pcb, Target_Jumper.kicad_sch, Target_Master.kicad_sch]
2026-04-06 Added Data Parsing, Events, and Handler to the UARTController.
